getc1995/Scaled-Robot-Cars/code/ubuntu/RC2/um_acc/samples/cpp/tutorial_code/images/imageTextN.png

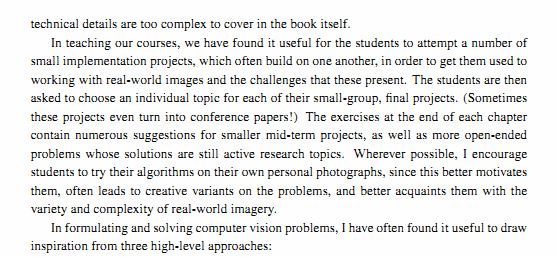
code/ubuntu/RC2/um_acc/samples/cpp/tutorial_code/images/imageTextN.png
