getc1995/Scaled-Robot-Cars/code/ubuntu/RC1/um_acc/samples/cpp/tutorial_code/images/chicky_512.png

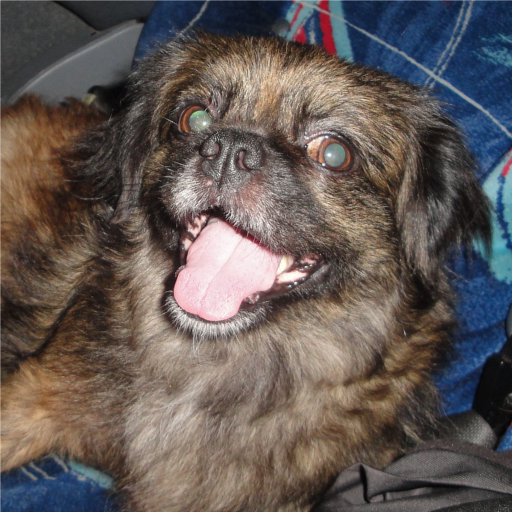
code/ubuntu/RC1/um_acc/samples/cpp/tutorial_code/images/chicky_512.png
