getc1995/Scaled-Robot-Cars/code/ubuntu/RC1/um_acc/cudd-2.5.0/cudd/doc/img22.png

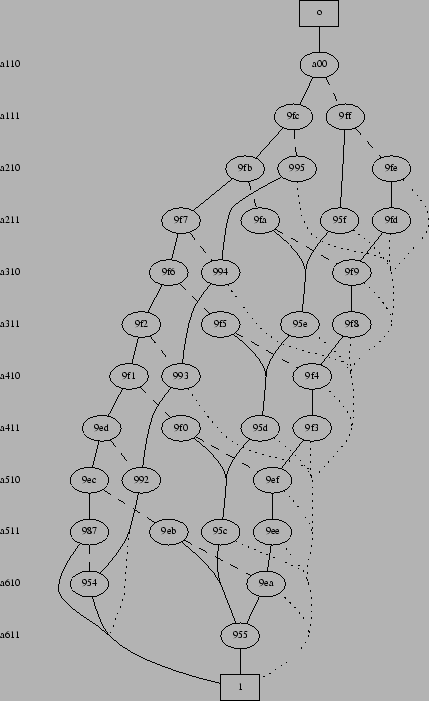
code/ubuntu/RC1/um_acc/cudd-2.5.0/cudd/doc/img22.png
