getc1995/Scaled-Robot-Cars/code/ubuntu/RC1/um_acc/samples/c/baboon200.jpg

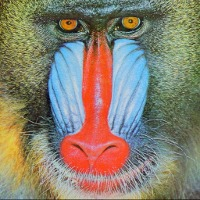
code/ubuntu/RC1/um_acc/samples/c/baboon200.jpg
