getc1995/Scaled-Robot-Cars/code/ubuntu/RC1/um_acc/samples/c/box.png

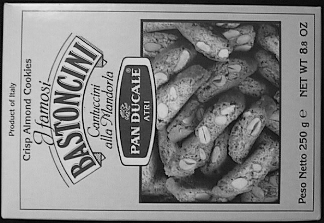
code/ubuntu/RC1/um_acc/samples/c/box.png
