getc1995/Scaled-Robot-Cars/code/ubuntu/RC1/um_acc/samples/c/one_way_train_0000.jpg

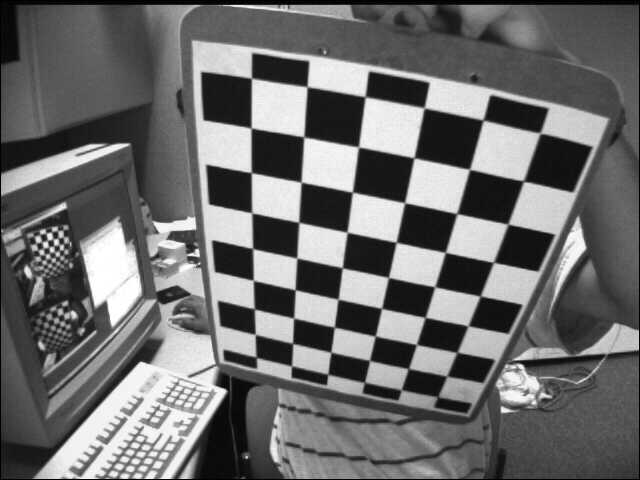
code/ubuntu/RC1/um_acc/samples/c/one_way_train_0000.jpg
