getc1995/Scaled-Robot-Cars/code/ubuntu/RC1/um_acc/samples/c/scene_l.bmp

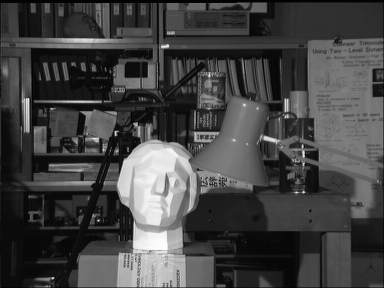
code/ubuntu/RC1/um_acc/samples/c/scene_l.bmp
