getc1995/Scaled-Robot-Cars/code/ubuntu/RC1/um_acc/samples/c/stuff.jpg

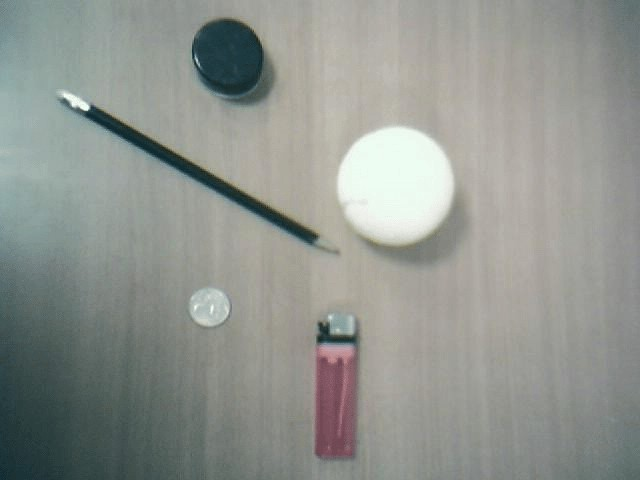
code/ubuntu/RC1/um_acc/samples/c/stuff.jpg
