getc1995/Scaled-Robot-Cars/code/ubuntu/RC1/um_acc/samples/cpp/matching_to_many_images/query.png

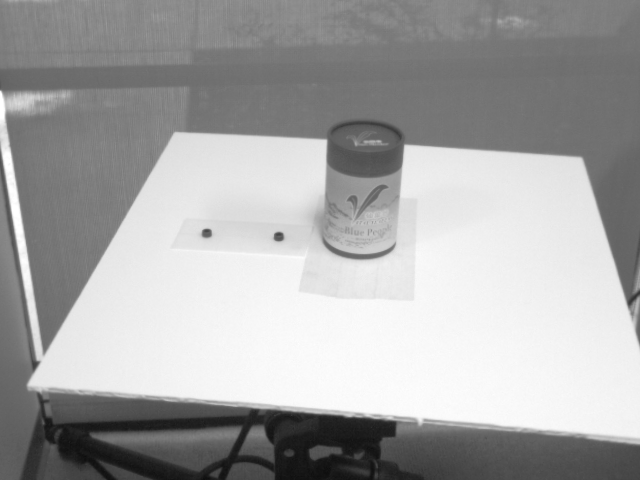
code/ubuntu/RC1/um_acc/samples/cpp/matching_to_many_images/query.png
