getc1995/Scaled-Robot-Cars/code/ubuntu/RC1/um_acc/samples/cpp/matching_to_many_images/train/1.png

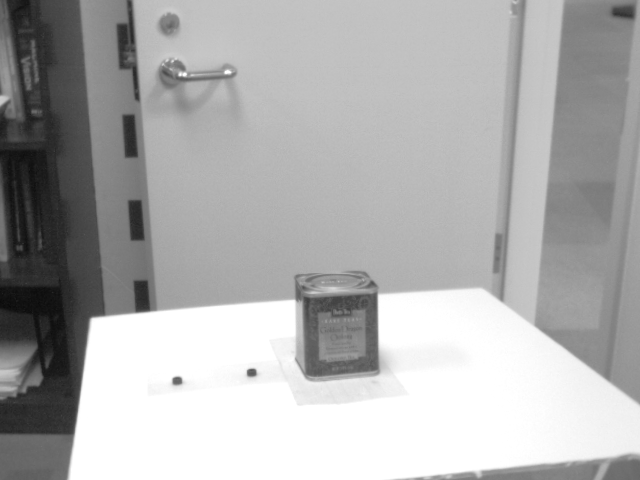
code/ubuntu/RC1/um_acc/samples/cpp/matching_to_many_images/train/1.png
