getc1995/Scaled-Robot-Cars/code/ubuntu/RC1/um_acc/samples/cpp/rgbdodometry/depth_00002.png

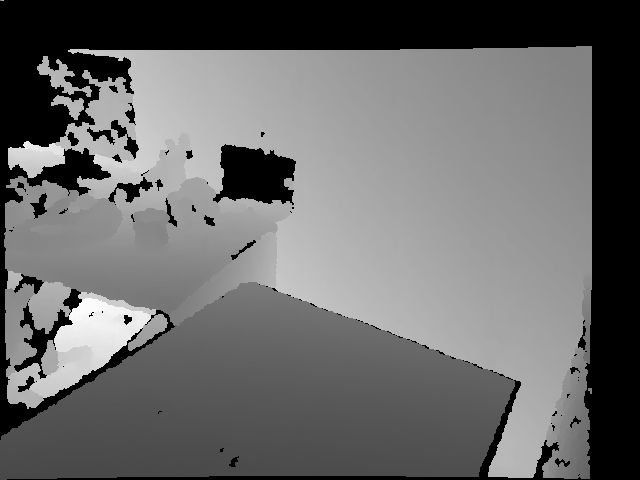
code/ubuntu/RC1/um_acc/samples/cpp/rgbdodometry/depth_00002.png
