getc1995/Scaled-Robot-Cars/code/ubuntu/RC1/um_acc/samples/cpp/rgbdodometry/image_00000.png

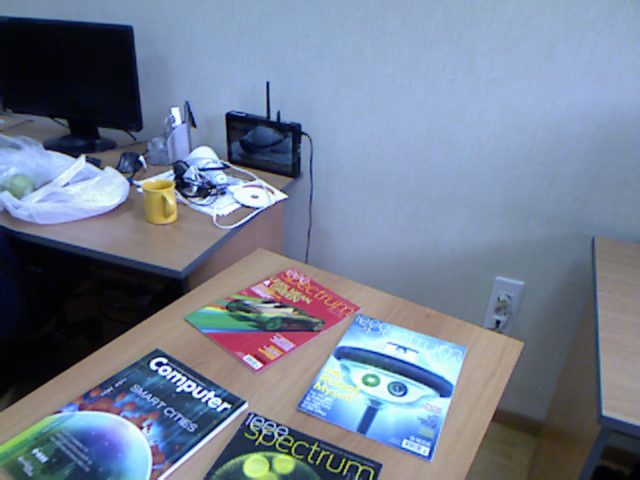
code/ubuntu/RC1/um_acc/samples/cpp/rgbdodometry/image_00000.png
