getc1995/Scaled-Robot-Cars/code/ubuntu/RC1/um_acc/samples/gpu/basketball2.png

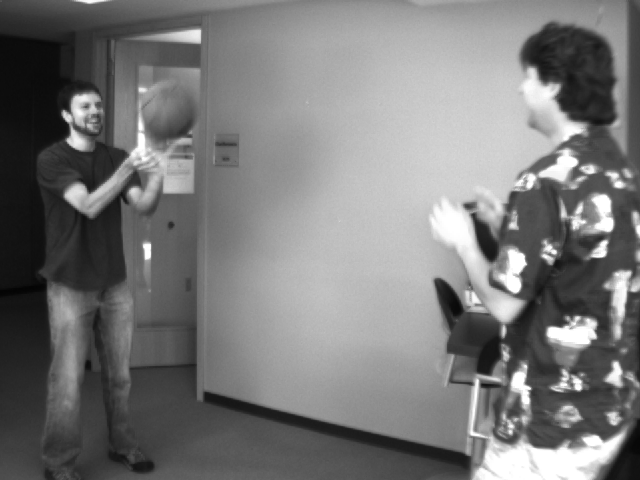
code/ubuntu/RC1/um_acc/samples/gpu/basketball2.png
