getc1995/Scaled-Robot-Cars/code/ubuntu/RC1/um_acc/samples/gpu/tsucuba_right.png

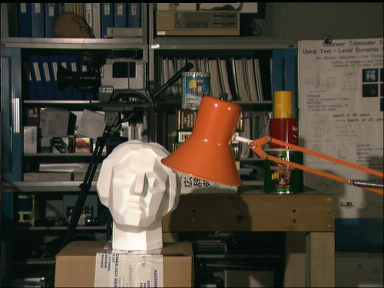
code/ubuntu/RC1/um_acc/samples/gpu/tsucuba_right.png
