getc1995/Scaled-Robot-Cars/code/ubuntu/RC1/um_acc/samples/java/clojure/simple-sample/resources/images/lena.png

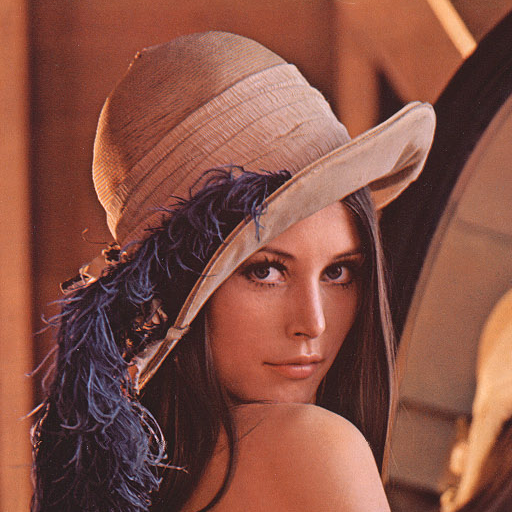
code/ubuntu/RC1/um_acc/samples/java/clojure/simple-sample/resources/images/lena.png
