getc1995/Scaled-Robot-Cars/code/ubuntu/RC1/um_acc/samples/java/sbt/src/main/resources/AverageMaleFace.jpg

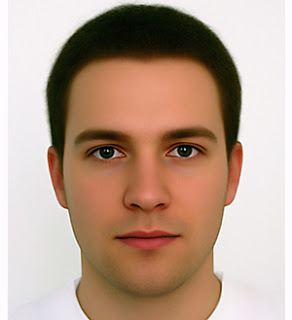
code/ubuntu/RC1/um_acc/samples/java/sbt/src/main/resources/AverageMaleFace.jpg
