getc1995/Scaled-Robot-Cars/code/ubuntu/RC1/um_acc/samples/python2/data/aero3.jpg

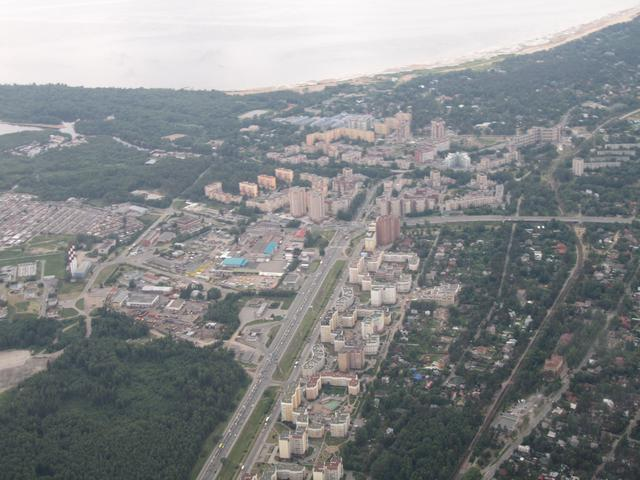
code/ubuntu/RC1/um_acc/samples/python2/data/aero3.jpg
