getc1995/Scaled-Robot-Cars/code/ubuntu/RC1/um_acc/samples/python2/data/starry_night.jpg

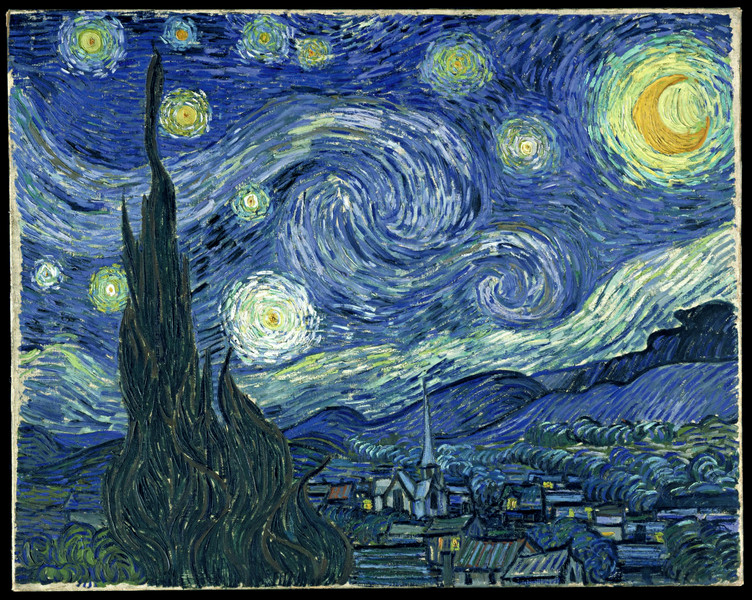
code/ubuntu/RC1/um_acc/samples/python2/data/starry_night.jpg
