getc1995/Scaled-Robot-Cars/code/ubuntu/RC1/um_acc/samples/python2/data/text_defocus.jpg

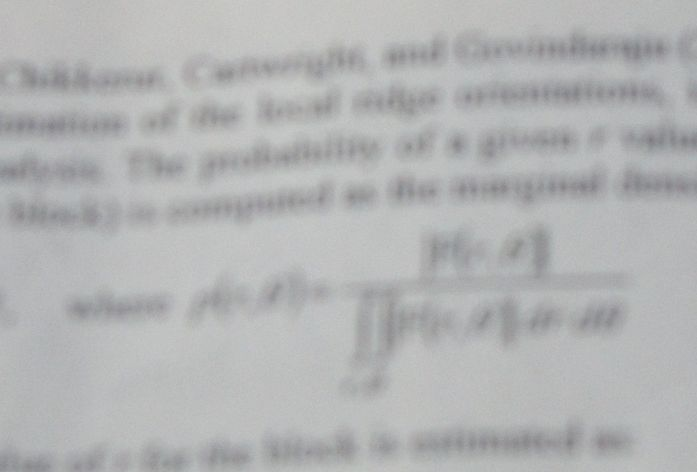
code/ubuntu/RC1/um_acc/samples/python2/data/text_defocus.jpg
