getc1995/Scaled-Robot-Cars/Build instruction/BOM.xlsx

Sheet: Amazon
Items | Price | Quantity | subtotal | Link
Gens ace 5000mAh 11.1V 3S 50C LiPo Battery Pack | 49.99 | 1 | 49.99 | https://www.amazon.com/dp/B01JCSOJIY?colid=3JGNW4QIKLVF0&coliid=I3M5W0S6SITRA4
1/4 th Inch Thick 12 x 12 Inches Acrylic Plexiglass Sheet | 12.99 | 4 | 51.96 | https://www.amazon.com/Source-Premium-Acrylic-PlexiGlass-S1-12x12-25/dp/B00844SOSE
Intocircuit LCD 60W 12V 5A Adapter Charger | 8.89 | 1 | 8.89 | https://www.amazon.com/dp/B0023Y9EQC?colid=3JGNW4QIKLVF0&coliid=I3FMTRIVJX96F
RioRand RC Hobby C23212 LiPo Voltage Checker + Warning Buzzer | 5.69 | 1 | 5.69 | https://www.amazon.com/dp/B003Y6E6IE?colid=3JGNW4QIKLVF0&coliid=I1TYB0BYTV1BZC
GoolRC SKYRC iMAX B6 Mini Professional Balance Charger / Discharger for RC Lipo Battery Charging | 42.99 | 1 | 42.99 | https://www.amazon.com/dp/B00L5YBJI2?colid=3JGNW4QIKLVF0&coliid=ISOXJGNL6SY91
Traxxas 2946 Charge Lead | 7.26 | 3 | 21.78 | https://www.amazon.com/dp/B00BMQGEZQ?colid=3JGNW4QIKLVF0&coliid=I37X9Q7A45ZTN4
WEN 74603 26-Inch 3 Drawer Intermediate Chest, Silver/Black | 63.74 | 1 | 63.74 | https://www.amazon.com/WEN-74603-26-Inch-Drawer-Intermediate/dp/B00B1NPU3W/ref=cm_wl_huc_item
Cal-Hawk 120 Fuses 5, 7.5, 10,15,20,25,30 AMP Automotive Fuses, Car Truck Fuses | 7.5 | 1 | 7.5 | https://www.amazon.com/Cal-Hawk-120-Fuses-Automotive-Truck/dp/B0042XORMI
 |  | total | 252.54

Sheet: Mcmaster
Items | Price | Quantity | subtotal | Link
Steel Phillips Rounded Head Screw M2 x 0.4 mm Thread, 10 mm Long | 3.67 | 1 | 3.67 | https://www.mcmaster.com/#92005A033
Aluminum Female Threaded Hex Standoff 6 mm Hex Size, 13 mm Length, M3 Thread Size | 0.52 | 20 | 10.4 | https://www.mcmaster.com/#95947A042
Aluminum Male-Female Threaded Hex Standoff 6 mm Hex Size, 31 mm Length, M3 Thread Size | 2.11 | 10 | 21.1 | https://www.mcmaster.com/#98952A073
Aluminum Female Threaded Hex Standoff 6 mm Hex Size, 30 mm Length, M3 Thread Size | 1.22 | 10 | 12.2 | https://www.mcmaster.com/#95947A060
Steel Hex Nut Low-Strength, M2 x 0.4 mm Thread | 1.04 | 1 | 1.04 | https://www.mcmaster.com/#90592A004
Medium-Strength Steel Nylon-Insert Locknut Class 8, Zinc-Plated, M3 x 0.5 mm Thread | 3.27 | 1 | 3.27 | https://www.mcmaster.com/#90576A102
Nylon Plastic Washer for M2 Screw Size, 2.2 mm ID, 5 mm OD | 2.63 | 1 | 2.63 | https://www.mcmaster.com/#95610a510/=16fyr81
Hex Drive Rounded Head Screw Black-Oxide Alloy Steel, M3 x 0.5 mm Thread, 10 mm Long | 6.88 | 1 | 6.88 | https://www.mcmaster.com/#91239A115
Hex Drive Rounded Head Screw Black-Oxide Alloy Steel, M3 x 0.5 mm Thread, 16 mm Long | 9.47 | 1 | 9.47 | https://www.mcmaster.com/#91239A120
Hex Drive Rounded Head Screw Black-Oxide Alloy Steel, M3 x 0.5 mm Thread, 6 mm Long | 6.88 | 1 | 6.88 | https://www.mcmaster.com/#91239A111
Nylon Plastic Washer for M3 Screw Size, 3.2 mm ID, 8 mm OD | 2.92 | 1 | 2.92 | https://www.mcmaster.com/#95610a530/=16fyry7
Steel Small-Parts Cabinet with 20 Plastic Drawers, 12" High x 16-1/2" Wide x 6-1/2" Deep | 90.25 | 1 | 90.25 | https://www.mcmaster.com/#4532T51
 |  | total | 170.71

Sheet: Robotshop
Items | Price | Quantity | subtotal | Link
LIDAR-Lite v3 | 119.67 | 1 | 119.67 | http://www.robotshop.com/en/lidar-lite-3-laser-rangefinder.html
LIDAR-Lite V3 Cable | 4.99 | 2 | 9.98 | http://www.robotshop.com/en/lidar-lite-v3-cable.html
SH-1 Soldering Iron Holder | 3.49 | 1 | 3.49 | http://www.robotshop.com/en/elenco-soldering-iron-holder.html
9 Degrees of Freedom - Razor M0 IMU | 49.95 | 1 | 49.95 | http://www.robotshop.com/en/9-degrees-of-freedom-razor-m0-imu.html
Classic Solderless Breadboard | 9.95 | 1 | 9.95 | http://www.robotshop.com/en/classic-solderless-breadboard.html
Terminal to 2.1mm Barrel Jack | 0.58 | 4 | 2.32 | http://www.robotshop.com/en/terminal-barrel-jack.html
Rocker Switch | 0.95 | 4 | 3.8 | http://www.robotshop.com/en/sfe-on-off-rocker-switch.html
Break Away Headers - Straight (10 pack) | 1.8 | 1 | 1.8 | http://www.robotshop.com/en/break-away-headers-straight.html
15A Waterproof Fuse Holder (Medium) | 4.18 | 1 | 4.18 | http://www.robotshop.com/en/15a-waterproof-fuse-holder-medium.html
 |  | total | 205.14

Sheet: Pololu
Items | Price | Quantity | subtotal | Link
Pololu 12V, 15A Step-Down Voltage Regulator D24V150F12 | 39.95 | 1 | 39.95 | https://www.pololu.com/product/2885
 |  | total | 39.95
