getc1995/Scaled-Robot-Cars/Build instruction/budget.xlsx

Sheet: A copy of the scaled car
 | unit price | Quantity
Motor | 300 | 1 | 300
Hokuyo UST-10LX Scanning Laser Rangefinder | 1700 | 1 | 1700
Traxxas 1/10 Slash 4X4 | 400 | 1 | 400
TK1 | 200 | 1 | 200
Arduino Mega | 40 | 1 | 40
3-Port USB 3.0 Portable Data Hub with 1 Gbps Ethernet | 24 | 1 | 24
USB 3.0 Hub | 8 | 1 | 8
IMU | 50 | 1 | 50
wiring and cables | 20 | 1 | 20
wifi | 80 | 1 | 80
3D printing and mechanical supports | 80 | 1 | 80
battery packs for motor | 60 | 1 | 60
battery packs for TK1 | 60 | 2 | 120
webcam | 30 | 1 | 30
 |  |  | 3112

Sheet: Encoder on the board
 | Unit Price | Quantity
Arduino Mega | 40 | 2 | 80
Bluetooth module | 10.59 | 2 | 21.18
Encoder | 17.99 | 1 | 17.99 | https://www.amazon.com/dp/B00UTIFCVA/_encoding=UTF8?coliid=I30JWL4OJGWUQ7&colid=3JGNW4QIKLVF0
Wheel | 10 | 1 | 10
Mechnical supports | 7.31 | 1 | 7.31
 |  |  | 136.48
