getc1995/Scaled-Robot-Cars/hardware/CAD/Assemble.SLDASM

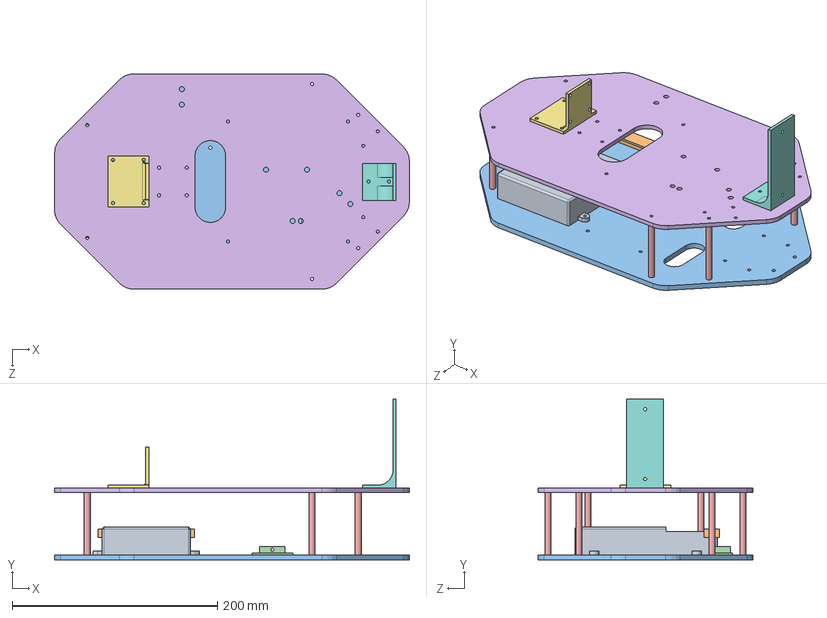
[picture p43: CAD file, 2018-04-26]
hardware/CAD/Assemble.SLDASM
346.3 x 157.0 x 210.0 mm
powerPack
door
lowerBase
switch
standing x 6
upperBase
LIDAR
wifi
