getc1995/Scaled-Robot-Cars/code/ubuntu/RC1/um_acc/samples/cpp/tutorial_code/viz/bunny.ply

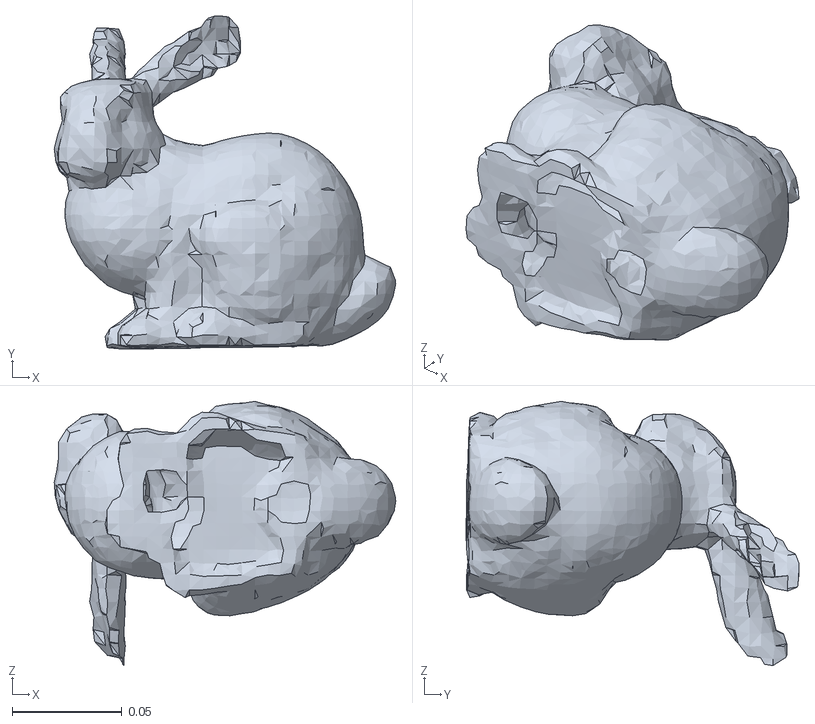
[picture p44: CAD file, 2018-04-26]
code/ubuntu/RC1/um_acc/samples/cpp/tutorial_code/viz/bunny.ply
0.155 x 0.151 x 0.12
