getc1995/Scaled-Robot-Cars/hardware/CAD/door.SLDPRT

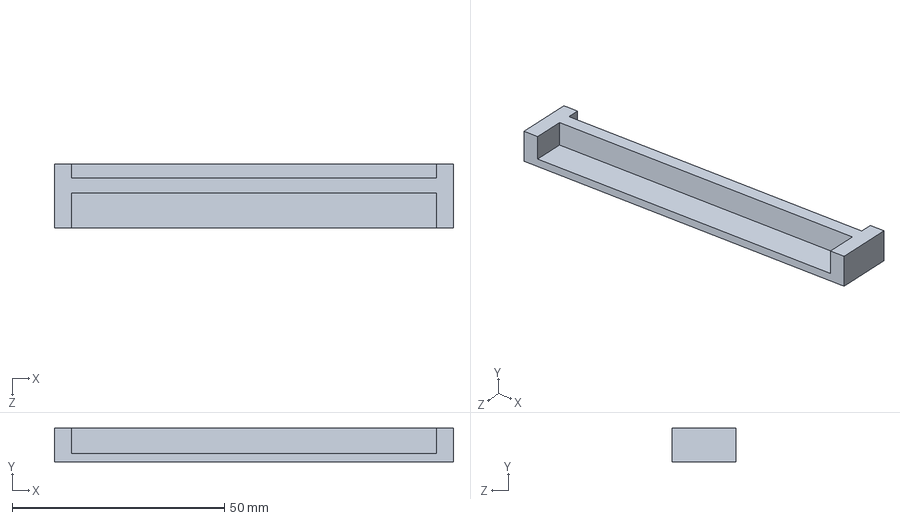
[picture p45: CAD file, 2018-04-26]
hardware/CAD/door.SLDPRT
94.0 x 8.00 x 15.0 mm
