getc1995/Scaled-Robot-Cars/hardware/CAD/wifi.SLDPRT

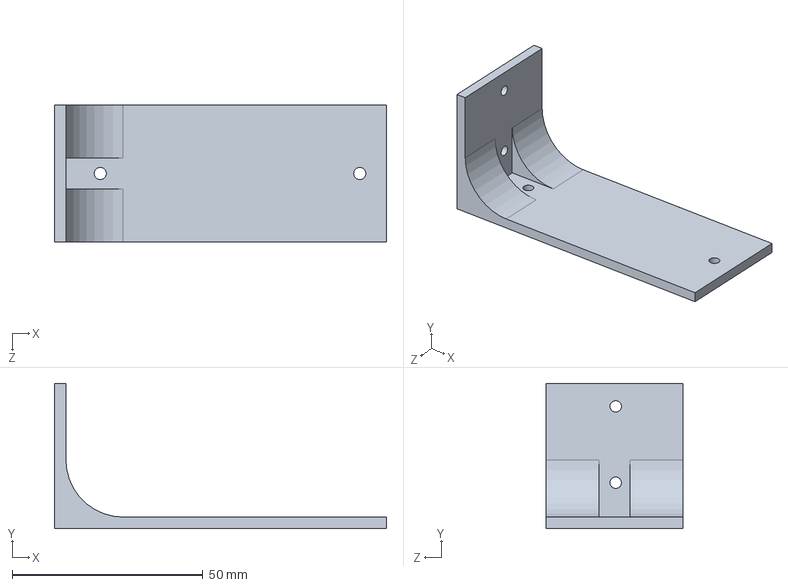
[picture p46: CAD file, 2018-04-26]
hardware/CAD/wifi.SLDPRT
87.0 x 38.0 x 36.0 mm
