getc1995/Scaled-Robot-Cars/hardware/CAD/upperBase2.SLDPRT

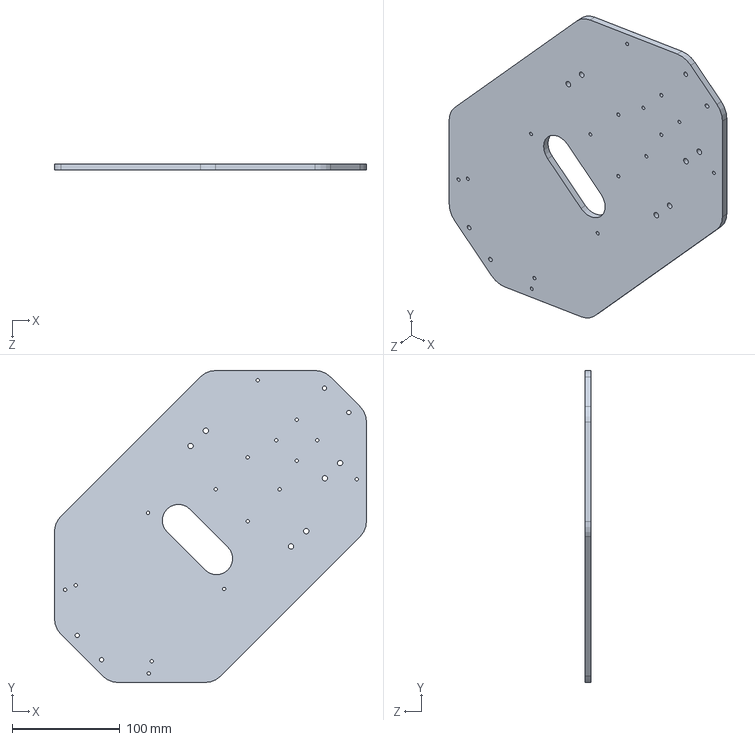
[picture p47: CAD file, 2018-04-26]
hardware/CAD/upperBase2.SLDPRT
290.0 x 290.0 x 6.00 mm
