getc1995/Scaled-Robot-Cars/hardware/CAD/switch.SLDPRT

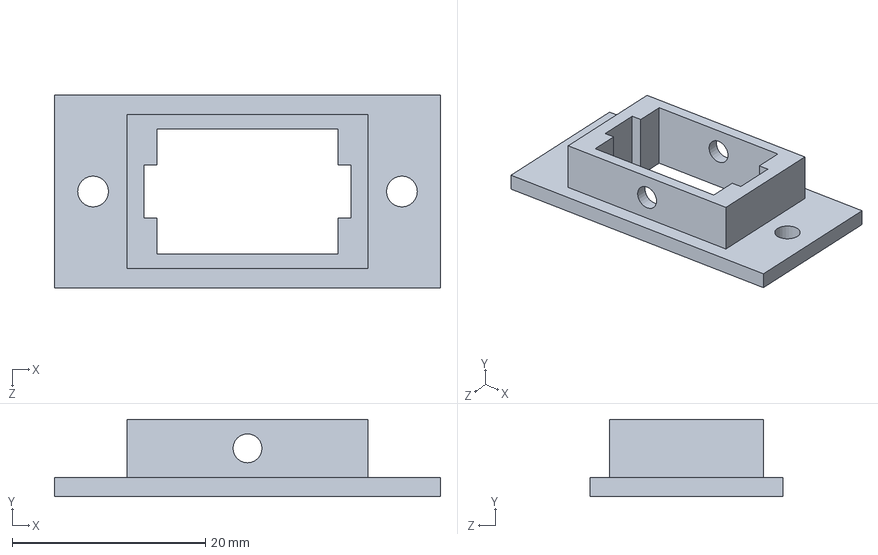
[picture p48: CAD file, 2018-04-26]
hardware/CAD/switch.SLDPRT
40.0 x 8.00 x 20.0 mm
