getc1995/Scaled-Robot-Cars/hardware/CAD/camera_mount.SLDPRT

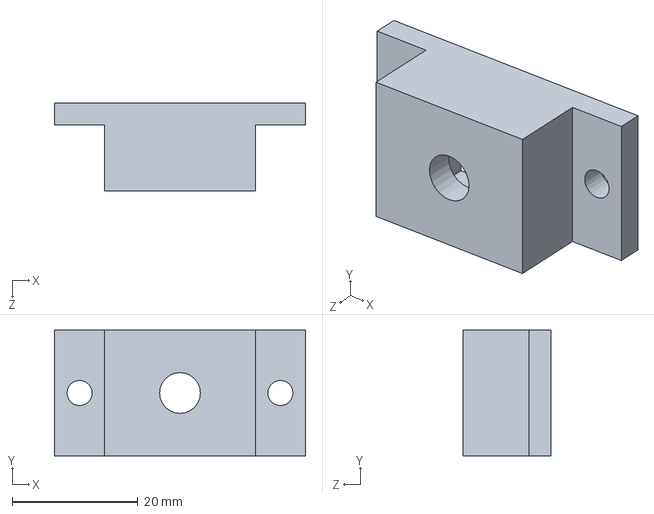
[picture p49: CAD file, 2018-04-26]
hardware/CAD/camera_mount.SLDPRT
40.0 x 20.0 x 14.0 mm
