getc1995/Scaled-Robot-Cars/hardware/CAD/standing.SLDPRT

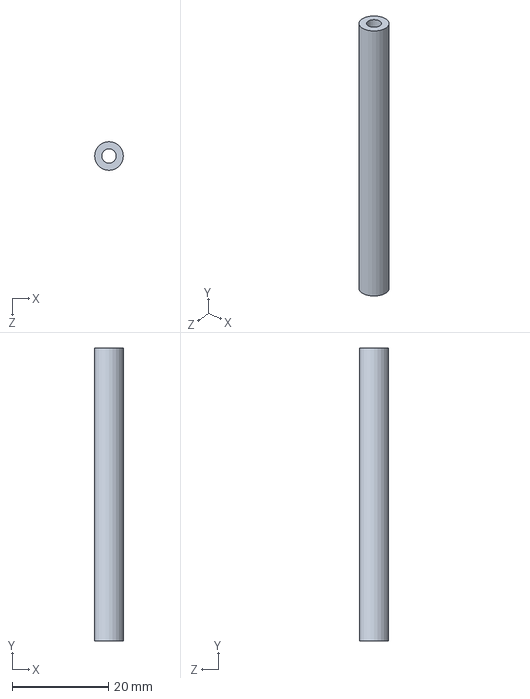
[picture p50: CAD file, 2018-04-26]
hardware/CAD/standing.SLDPRT
6.00 x 61.0 x 6.00 mm
