getc1995/Scaled-Robot-Cars/hardware/CAD/lowerBase.SLDPRT

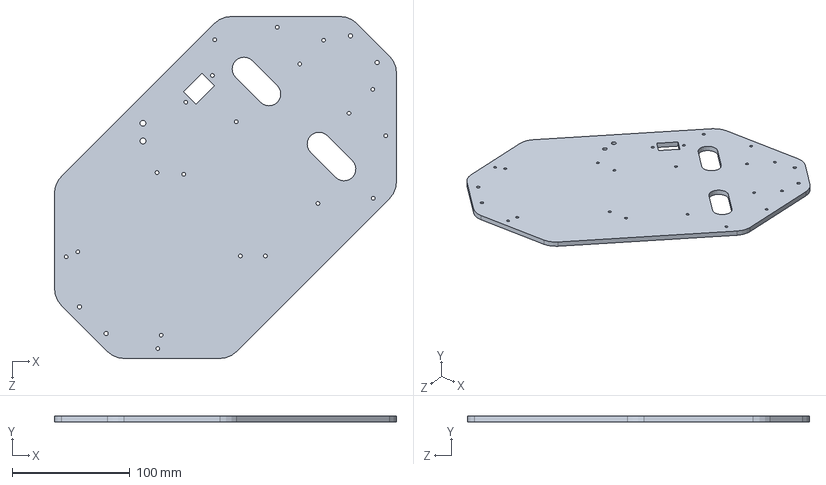
[picture p51: CAD file, 2018-04-26]
hardware/CAD/lowerBase.SLDPRT
290.0 x 5.00 x 290.0 mm
