getc1995/Scaled-Robot-Cars/hardware/CAD/powerPack.SLDPRT

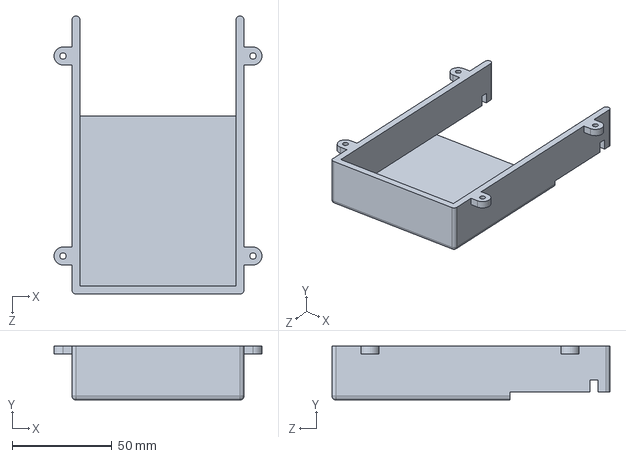
[picture p52: CAD file, 2018-04-26]
hardware/CAD/powerPack.SLDPRT
104.0 x 27.0 x 139.0 mm
