getc1995/Scaled-Robot-Cars/hardware/CAD/LIDAR.SLDPRT

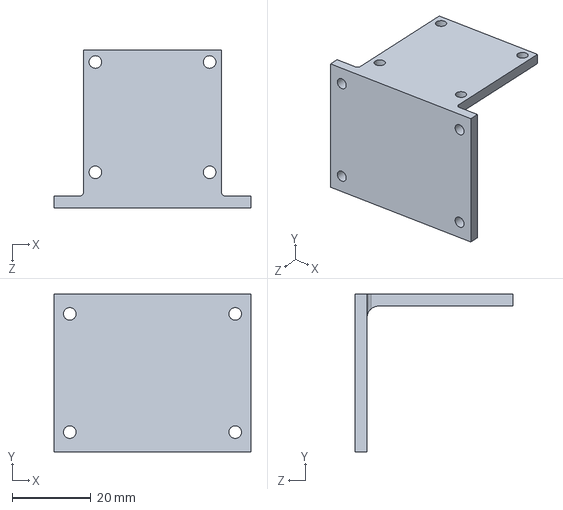
[picture p53: CAD file, 2018-04-26]
hardware/CAD/LIDAR.SLDPRT
50.0 x 40.0 x 40.0 mm
