getc1995/Scaled-Robot-Cars/hardware/CAD/Elmo.SLDPRT

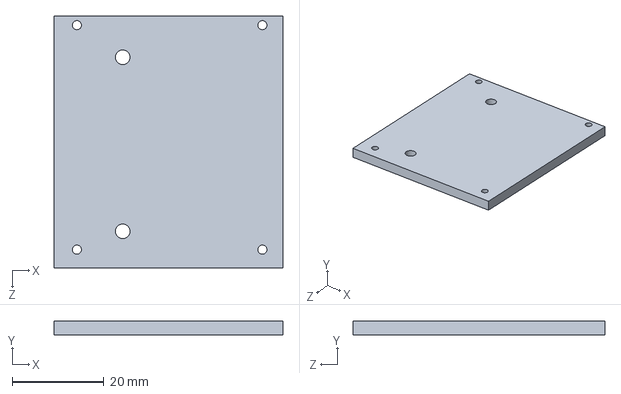
[picture p54: CAD file, 2018-04-26]
hardware/CAD/Elmo.SLDPRT
50.0 x 3.00 x 55.0 mm
