getc1995/Scaled-Robot-Cars/hardware/CAD/upperBase.SLDPRT

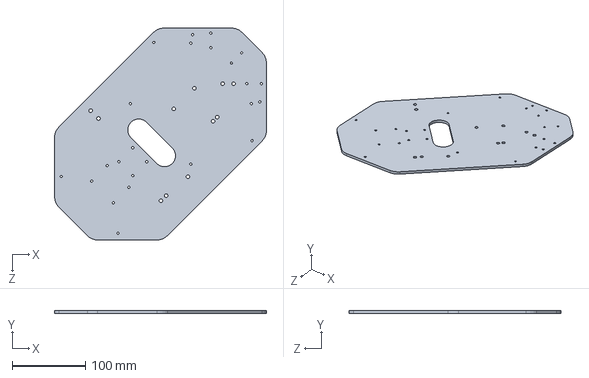
[picture p55: CAD file, 2018-04-26]
hardware/CAD/upperBase.SLDPRT
290.0 x 4.00 x 290.0 mm
