getc1995/Scaled-Robot-Cars/(list of files, cad)

Other CAD files:
hardware/CAD/lowerBase2.SLDPRT
hardware/CAD/Elmo.STL
hardware/CAD/LIDAR.STL
hardware/CAD/camera_mount.STL
hardware/CAD/door.STL
hardware/CAD/powerPack.STL
hardware/CAD/switch.STL
hardware/CAD/wifi.STL
