getc1995/Scaled-Robot-Cars/Build instruction/Documentation.docx

Documentation

Edit the script to execute on the start of terminal:

gedit ~/.bashrc

ros rviz segmentation fault:

echo "unset GTK_IM_MODULE" >> ~/.bashrc

source ~/.bashrc

(Restart terminal)
