getc1995/Scaled-Robot-Cars/code/ubuntu/RC1/um_acc/samples/cpp/tutorial_code/images/hand_sample3.jpg

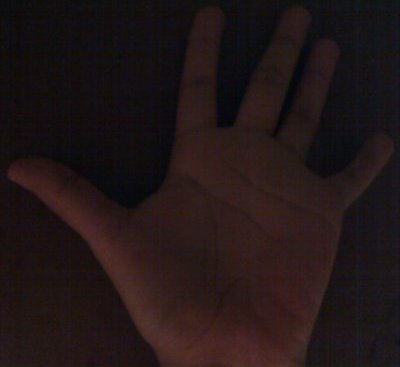
code/ubuntu/RC1/um_acc/samples/cpp/tutorial_code/images/hand_sample3.jpg
