getc1995/Scaled-Robot-Cars/code/ubuntu/RC1/um_acc/samples/cpp/tutorial_code/images/imageTextR.png

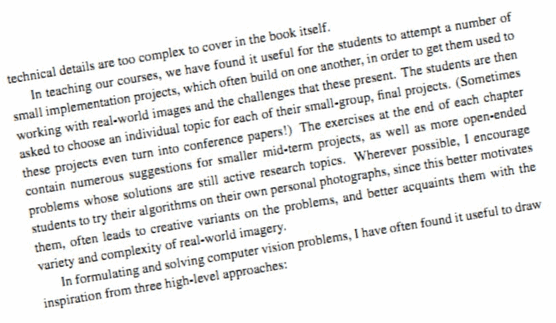
code/ubuntu/RC1/um_acc/samples/cpp/tutorial_code/images/imageTextR.png
