getc1995/Scaled-Robot-Cars/code/ubuntu/RC1/um_acc/camera_calibration/picture2.jpg

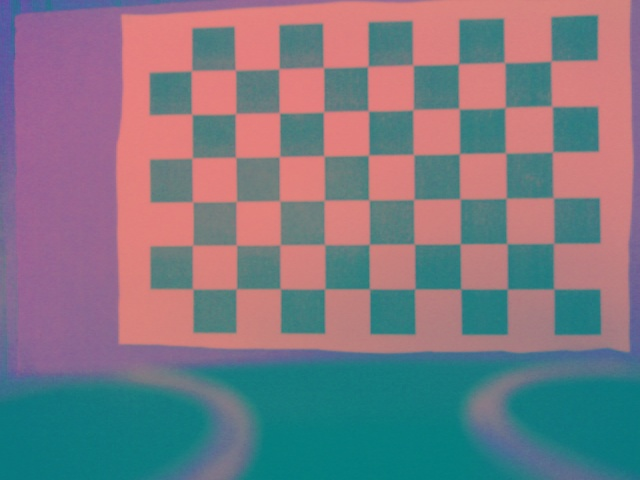
code/ubuntu/RC1/um_acc/camera_calibration/picture2.jpg
