getc1995/Scaled-Robot-Cars/code/ubuntu/RC1/um_acc/samples/cpp/fabmap/stlucia_test_small0002.jpeg

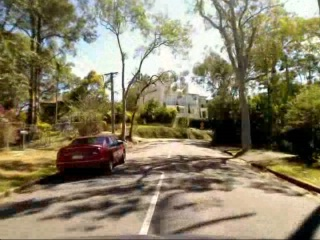
code/ubuntu/RC1/um_acc/samples/cpp/fabmap/stlucia_test_small0002.jpeg
