getc1995/Scaled-Robot-Cars/code/ubuntu/RC1/um_acc/samples/cpp/fabmap/stlucia_test_small0004.jpeg

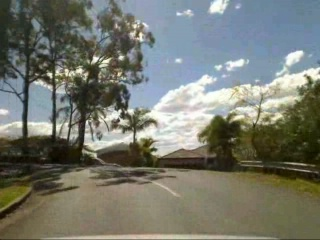
code/ubuntu/RC1/um_acc/samples/cpp/fabmap/stlucia_test_small0004.jpeg
