getc1995/Scaled-Robot-Cars/code/ubuntu/RC1/um_acc/src/Car_parameters.h

#define CPS2V 0.004653//countPerSecond to velocity
#define MAXCURRENT 0.25
#define SERVOMID 1419
#define SERVOMAXAMP 200 //Maximal servo amplitude
#define CARID 1
