getc1995/Scaled-Robot-Cars/code/ubuntu/RC1/um_acc/src/accsolver.cpp

/* Produced by CVXGEN, 2018-02-12 21:04:51 -0500.  */
/* CVXGEN is Copyright (C) 2006-2017 Jacob Mattingley, jem@cvxgen.com. */
/* The code in this file is Copyright (C) 2006-2017 Jacob Mattingley. */
/* CVXGEN, or solvers produced by CVXGEN, cannot be used for commercial */
/* applications without prior written permission from Jacob Mattingley. */

/* Filename: solver.c. */
/* Description: Main solver file. */
#include "accsolver.h"
double eval_gap(void) {
  int i;
  double gap;
  gap = 0;
  for (i = 0; i < 100; i++)
    gap += work.z[i]*work.s[i];
  return gap;
}
void set_defaults(void) {
  settings.resid_tol = 1e-6;
  settings.eps = 1e-4;
  settings.max_iters = 25;
  settings.refine_steps = 1;
  settings.s_init = 1;
  settings.z_init = 1;
  settings.debug = 0;
  settings.verbose = 1;
  settings.verbose_refinement = 0;
  settings.better_start = 1;
  settings.kkt_reg = 1e-7;
}
void setup_pointers(void) {
  work.y = work.x + 159;
  work.s = work.x + 298;
  work.z = work.x + 398;
  vars.u_1 = work.x + 59;
  vars.u_2 = work.x + 60;
  vars.u_3 = work.x + 61;
  vars.u_4 = work.x + 62;
  vars.u_5 = work.x + 63;
  vars.u_6 = work.x + 64;
  vars.u_7 = work.x + 65;
  vars.u_8 = work.x + 66;
  vars.u_9 = work.x + 67;
  vars.u_10 = work.x + 68;
  vars.u_11 = work.x + 69;
  vars.u_12 = work.x + 70;
  vars.u_13 = work.x + 71;
  vars.u_14 = work.x + 72;
  vars.u_15 = work.x + 73;
  vars.u_16 = work.x + 74;
  vars.u_17 = work.x + 75;
  vars.u_18 = work.x + 76;
  vars.u_19 = work.x + 77;
  vars.u_20 = work.x + 78;
  vars.x_1 = work.x + 79;
  vars.x_2 = work.x + 81;
  vars.x_3 = work.x + 83;
  vars.x_4 = work.x + 85;
  vars.x_5 = work.x + 87;
  vars.x_6 = work.x + 89;
  vars.x_7 = work.x + 91;
  vars.x_8 = work.x + 93;
  vars.x_9 = work.x + 95;
  vars.x_10 = work.x + 97;
  vars.x_11 = work.x + 99;
  vars.x_12 = work.x + 101;
  vars.x_13 = work.x + 103;
  vars.x_14 = work.x + 105;
  vars.x_15 = work.x + 107;
  vars.x_16 = work.x + 109;
  vars.x_17 = work.x + 111;
  vars.x_18 = work.x + 113;
  vars.x_19 = work.x + 115;
  vars.x_20 = work.x + 117;
  vars.xr_1 = work.x + 119;
  vars.xr_2 = work.x + 121;
  vars.xr_3 = work.x + 123;
  vars.xr_4 = work.x + 125;
  vars.xr_5 = work.x + 127;
  vars.xr_6 = work.x + 129;
  vars.xr_7 = work.x + 131;
  vars.xr_8 = work.x + 133;
  vars.xr_9 = work.x + 135;
  vars.xr_10 = work.x + 137;
  vars.xr_11 = work.x + 139;
  vars.xr_12 = work.x + 141;
  vars.xr_13 = work.x + 143;
  vars.xr_14 = work.x + 145;
  vars.xr_15 = work.x + 147;
  vars.xr_16 = work.x + 149;
  vars.xr_17 = work.x + 151;
  vars.xr_18 = work.x + 153;
  vars.xr_19 = work.x + 155;
  vars.xr_20 = work.x + 157;
}
void setup_indexed_params(void) {
  /* In CVXGEN, you can say */
  /*   parameters */
  /*     A[i] (5,3), i=1..4 */
  /*   end */
  /* This function sets up A[2] to be a pointer to A_2, which is a length-15 */
  /* vector of doubles. */
  /* If you access parameters that you haven't defined in CVXGEN, the result */
  /* is undefined. */
  params.u[0] = params.u_0;
  params.x[0] = params.x_0;
}
void setup_indexed_optvars(void) {
  /* In CVXGEN, you can say */
  /*   variables */
  /*     x[i] (5), i=2..4 */
  /*   end */
  /* This function sets up x[3] to be a pointer to x_3, which is a length-5 */
  /* vector of doubles. */
  /* If you access variables that you haven't defined in CVXGEN, the result */
  /* is undefined. */
  vars.x[1] = vars.x_1;
  vars.xr[1] = vars.xr_1;
  vars.x[2] = vars.x_2;
  vars.xr[2] = vars.xr_2;
  vars.x[3] = vars.x_3;
  vars.xr[3] = vars.xr_3;
  vars.x[4] = vars.x_4;
  vars.xr[4] = vars.xr_4;
  vars.x[5] = vars.x_5;
  vars.xr[5] = vars.xr_5;
  vars.x[6] = vars.x_6;
  vars.xr[6] = vars.xr_6;
  vars.x[7] = vars.x_7;
  vars.xr[7] = vars.xr_7;
  vars.x[8] = vars.x_8;
  vars.xr[8] = vars.xr_8;
  vars.x[9] = vars.x_9;
  vars.xr[9] = vars.xr_9;
  vars.x[10] = vars.x_10;
  vars.xr[10] = vars.xr_10;
  vars.x[11] = vars.x_11;
  vars.xr[11] = vars.xr_11;
  vars.x[12] = vars.x_12;
  vars.xr[12] = vars.xr_12;
  vars.x[13] = vars.x_13;
  vars.xr[13] = vars.xr_13;
  vars.x[14] = vars.x_14;
  vars.xr[14] = vars.xr_14;
  vars.x[15] = vars.x_15;
  vars.xr[15] = vars.xr_15;
  vars.x[16] = vars.x_16;
  vars.xr[16] = vars.xr_16;
  vars.x[17] = vars.x_17;
  vars.xr[17] = vars.xr_17;
  vars.x[18] = vars.x_18;
  vars.xr[18] = vars.xr_18;
  vars.x[19] = vars.x_19;
  vars.xr[19] = vars.xr_19;
  vars.x[20] = vars.x_20;
  vars.xr[20] = vars.xr_20;
  vars.u[1] = vars.u_1;
  vars.u[2] = vars.u_2;
  vars.u[3] = vars.u_3;
  vars.u[4] = vars.u_4;
  vars.u[5] = vars.u_5;
  vars.u[6] = vars.u_6;
  vars.u[7] = vars.u_7;
  vars.u[8] = vars.u_8;
  vars.u[9] = vars.u_9;
  vars.u[10] = vars.u_10;
  vars.u[11] = vars.u_11;
  vars.u[12] = vars.u_12;
  vars.u[13] = vars.u_13;
  vars.u[14] = vars.u_14;
  vars.u[15] = vars.u_15;
  vars.u[16] = vars.u_16;
  vars.u[17] = vars.u_17;
  vars.u[18] = vars.u_18;
  vars.u[19] = vars.u_19;
  vars.u[20] = vars.u_20;
}
void setup_indexing(void) {
  setup_pointers();
  setup_indexed_params();
  setup_indexed_optvars();
}
void set_start(void) {
  int i;
  for (i = 0; i < 159; i++)
    work.x[i] = 0;
  for (i = 0; i < 139; i++)
    work.y[i] = 0;
  for (i = 0; i < 100; i++)
    work.s[i] = (work.h[i] > 0) ? work.h[i] : settings.s_init;
  for (i = 0; i < 100; i++)
    work.z[i] = settings.z_init;
}
double eval_objv(void) {
  int i;
  double objv;
  /* Borrow space in work.rhs. */
  multbyP(work.rhs, work.x);
  objv = 0;
  for (i = 0; i < 159; i++)
    objv += work.x[i]*work.rhs[i];
  objv *= 0.5;
  for (i = 0; i < 159; i++)
    objv += work.q[i]*work.x[i];
  objv += work.quad_397717204992[0];
  return objv;
}
void fillrhs_aff(void) {
  int i;
  double *r1, *r2, *r3, *r4;
  r1 = work.rhs;
  r2 = work.rhs + 159;
  r3 = work.rhs + 259;
  r4 = work.rhs + 359;
  /* r1 = -A^Ty - G^Tz - Px - q. */
  multbymAT(r1, work.y);
  multbymGT(work.buffer, work.z);
  for (i = 0; i < 159; i++)
    r1[i] += work.buffer[i];
  multbyP(work.buffer, work.x);
  for (i = 0; i < 159; i++)
    r1[i] -= work.buffer[i] + work.q[i];
  /* r2 = -z. */
  for (i = 0; i < 100; i++)
    r2[i] = -work.z[i];
  /* r3 = -Gx - s + h. */
  multbymG(r3, work.x);
  for (i = 0; i < 100; i++)
    r3[i] += -work.s[i] + work.h[i];
  /* r4 = -Ax + b. */
  multbymA(r4, work.x);
  for (i = 0; i < 139; i++)
    r4[i] += work.b[i];
}
void fillrhs_cc(void) {
  int i;
  double *r2;
  double *ds_aff, *dz_aff;
  double mu;
  double alpha;
  double sigma;
  double smu;
  double minval;
  r2 = work.rhs + 159;
  ds_aff = work.lhs_aff + 159;
  dz_aff = work.lhs_aff + 259;
  mu = 0;
  for (i = 0; i < 100; i++)
    mu += work.s[i]*work.z[i];
  /* Don't finish calculating mu quite yet. */
  /* Find min(min(ds./s), min(dz./z)). */
  minval = 0;
  for (i = 0; i < 100; i++)
    if (ds_aff[i] < minval*work.s[i])
      minval = ds_aff[i]/work.s[i];
  for (i = 0; i < 100; i++)
    if (dz_aff[i] < minval*work.z[i])
      minval = dz_aff[i]/work.z[i];
  /* Find alpha. */
  if (-1 < minval)
      alpha = 1;
  else
      alpha = -1/minval;
  sigma = 0;
  for (i = 0; i < 100; i++)
    sigma += (work.s[i] + alpha*ds_aff[i])*
      (work.z[i] + alpha*dz_aff[i]);
  sigma /= mu;
  sigma = sigma*sigma*sigma;
  /* Finish calculating mu now. */
  mu *= 0.01;
  smu = sigma*mu;
  /* Fill-in the rhs. */
  for (i = 0; i < 159; i++)
    work.rhs[i] = 0;
  for (i = 259; i < 498; i++)
    work.rhs[i] = 0;
  for (i = 0; i < 100; i++)
    r2[i] = work.s_inv[i]*(smu - ds_aff[i]*dz_aff[i]);
}
void refine(double *target, double *var) {
  int i, j;
  double *residual = work.buffer;
  double norm2;
  double *new_var = work.buffer2;
  for (j = 0; j < settings.refine_steps; j++) {
    norm2 = 0;
    matrix_multiply(residual, var);
    for (i = 0; i < 498; i++) {
      residual[i] = residual[i] - target[i];
      norm2 += residual[i]*residual[i];
    }
#ifndef ZERO_LIBRARY_MODE
    if (settings.verbose_refinement) {
      if (j == 0)
        printf("Initial residual before refinement has norm squared %.6g.\n", norm2);
      else
        printf("After refinement we get squared norm %.6g.\n", norm2);
    }
#endif
    /* Solve to find new_var = KKT \ (target - A*var). */
    ldl_solve(residual, new_var);
    /* Update var += new_var, or var += KKT \ (target - A*var). */
    for (i = 0; i < 498; i++) {
      var[i] -= new_var[i];
    }
  }
#ifndef ZERO_LIBRARY_MODE
  if (settings.verbose_refinement) {
    /* Check the residual once more, but only if we're reporting it, since */
    /* it's expensive. */
    norm2 = 0;
    matrix_multiply(residual, var);
    for (i = 0; i < 498; i++) {
      residual[i] = residual[i] - target[i];
      norm2 += residual[i]*residual[i];
    }
    if (j == 0)
      printf("Initial residual before refinement has norm squared %.6g.\n", norm2);
    else
      printf("After refinement we get squared norm %.6g.\n", norm2);
  }
#endif
}
double calc_ineq_resid_squared(void) {
  /* Calculates the norm ||-Gx - s + h||. */
  double norm2_squared;
  int i;
  /* Find -Gx. */
  multbymG(work.buffer, work.x);
  /* Add -s + h. */
  for (i = 0; i < 100; i++)
    work.buffer[i] += -work.s[i] + work.h[i];
  /* Now find the squared norm. */
  norm2_squared = 0;
  for (i = 0; i < 100; i++)
    norm2_squared += work.buffer[i]*work.buffer[i];
  return norm2_squared;
}
double calc_eq_resid_squared(void) {
  /* Calculates the norm ||-Ax + b||. */
  double norm2_squared;
  int i;
  /* Find -Ax. */
  multbymA(work.buffer, work.x);
  /* Add +b. */
  for (i = 0; i < 139; i++)
    work.buffer[i] += work.b[i];
  /* Now find the squared norm. */
  norm2_squared = 0;
  for (i = 0; i < 139; i++)
    norm2_squared += work.buffer[i]*work.buffer[i];
  return norm2_squared;
}
void better_start(void) {
  /* Calculates a better starting point, using a similar approach to CVXOPT. */
  /* Not yet speed optimized. */
  int i;
  double *x, *s, *z, *y;
  double alpha;
  work.block_33[0] = -1;
  /* Make sure sinvz is 1 to make hijacked KKT system ok. */
  for (i = 0; i < 100; i++)
    work.s_inv_z[i] = 1;
  fill_KKT();
  ldl_factor();
  fillrhs_start();
  /* Borrow work.lhs_aff for the solution. */
  ldl_solve(work.rhs, work.lhs_aff);
  /* Don't do any refinement for now. Precision doesn't matter too much. */
  x = work.lhs_aff;
  s = work.lhs_aff + 159;
  z = work.lhs_aff + 259;
  y = work.lhs_aff + 359;
  /* Just set x and y as is. */
  for (i = 0; i < 159; i++)
    work.x[i] = x[i];
  for (i = 0; i < 139; i++)
    work.y[i] = y[i];
  /* Now complete the initialization. Start with s. */
  /* Must have alpha > max(z). */
  alpha = -1e99;
  for (i = 0; i < 100; i++)
    if (alpha < z[i])
      alpha = z[i];
  if (alpha < 0) {
    for (i = 0; i < 100; i++)
      work.s[i] = -z[i];
  } else {
    alpha += 1;
    for (i = 0; i < 100; i++)
      work.s[i] = -z[i] + alpha;
  }
  /* Now initialize z. */
  /* Now must have alpha > max(-z). */
  alpha = -1e99;
  for (i = 0; i < 100; i++)
    if (alpha < -z[i])
      alpha = -z[i];
  if (alpha < 0) {
    for (i = 0; i < 100; i++)
      work.z[i] = z[i];
  } else {
    alpha += 1;
    for (i = 0; i < 100; i++)
      work.z[i] = z[i] + alpha;
  }
}
void fillrhs_start(void) {
  /* Fill rhs with (-q, 0, h, b). */
  int i;
  double *r1, *r2, *r3, *r4;
  r1 = work.rhs;
  r2 = work.rhs + 159;
  r3 = work.rhs + 259;
  r4 = work.rhs + 359;
  for (i = 0; i < 159; i++)
    r1[i] = -work.q[i];
  for (i = 0; i < 100; i++)
    r2[i] = 0;
  for (i = 0; i < 100; i++)
    r3[i] = work.h[i];
  for (i = 0; i < 139; i++)
    r4[i] = work.b[i];
}
long solve(void) {
  int i;
  int iter;
  double *dx, *ds, *dy, *dz;
  double minval;
  double alpha;
  work.converged = 0;
  setup_pointers();
  pre_ops();
#ifndef ZERO_LIBRARY_MODE
  if (settings.verbose)
    printf("iter     objv        gap       |Ax-b|    |Gx+s-h|    step\n");
#endif
  fillq();
  fillh();
  fillb();
  if (settings.better_start)
    better_start();
  else
    set_start();
  for (iter = 0; iter < settings.max_iters; iter++) {
    for (i = 0; i < 100; i++) {
      work.s_inv[i] = 1.0 / work.s[i];
      work.s_inv_z[i] = work.s_inv[i]*work.z[i];
    }
    work.block_33[0] = 0;
    fill_KKT();
    ldl_factor();
    /* Affine scaling directions. */
    fillrhs_aff();
    ldl_solve(work.rhs, work.lhs_aff);
    refine(work.rhs, work.lhs_aff);
    /* Centering plus corrector directions. */
    fillrhs_cc();
    ldl_solve(work.rhs, work.lhs_cc);
    refine(work.rhs, work.lhs_cc);
    /* Add the two together and store in aff. */
    for (i = 0; i < 498; i++)
      work.lhs_aff[i] += work.lhs_cc[i];
    /* Rename aff to reflect its new meaning. */
    dx = work.lhs_aff;
    ds = work.lhs_aff + 159;
    dz = work.lhs_aff + 259;
    dy = work.lhs_aff + 359;
    /* Find min(min(ds./s), min(dz./z)). */
    minval = 0;
    for (i = 0; i < 100; i++)
      if (ds[i] < minval*work.s[i])
        minval = ds[i]/work.s[i];
    for (i = 0; i < 100; i++)
      if (dz[i] < minval*work.z[i])
        minval = dz[i]/work.z[i];
    /* Find alpha. */
    if (-0.99 < minval)
      alpha = 1;
    else
      alpha = -0.99/minval;
    /* Update the primal and dual variables. */
    for (i = 0; i < 159; i++)
      work.x[i] += alpha*dx[i];
    for (i = 0; i < 100; i++)
      work.s[i] += alpha*ds[i];
    for (i = 0; i < 100; i++)
      work.z[i] += alpha*dz[i];
    for (i = 0; i < 139; i++)
      work.y[i] += alpha*dy[i];
    work.gap = eval_gap();
    work.eq_resid_squared = calc_eq_resid_squared();
    work.ineq_resid_squared = calc_ineq_resid_squared();
#ifndef ZERO_LIBRARY_MODE
    if (settings.verbose) {
      work.optval = eval_objv();
      printf("%3d   %10.3e  %9.2e  %9.2e  %9.2e  % 6.4f\n",
          iter+1, work.optval, work.gap, sqrt(work.eq_resid_squared),
          sqrt(work.ineq_resid_squared), alpha);
    }
#endif
    /* Test termination conditions. Requires optimality, and satisfied */
    /* constraints. */
    if (   (work.gap < settings.eps)
        && (work.eq_resid_squared <= settings.resid_tol*settings.resid_tol)
        && (work.ineq_resid_squared <= settings.resid_tol*settings.resid_tol)
       ) {
      work.converged = 1;
      work.optval = eval_objv();
      return iter+1;
    }
  }
  return iter;
}
#include <time.h>
#include <stdlib.h>
#include <math.h>
long global_seed = 1;
static clock_t tic_timestart;
void tic(void) {
  tic_timestart = clock();
}
float toc(void) {
  clock_t tic_timestop;
  tic_timestop = clock();
  printf("time: %8.2f.\n", (float)(tic_timestop - tic_timestart) / CLOCKS_PER_SEC);
  return (float)(tic_timestop - tic_timestart) / CLOCKS_PER_SEC;
}
float tocq(void) {
  clock_t tic_timestop;
  tic_timestop = clock();
  return (float)(tic_timestop - tic_timestart) / CLOCKS_PER_SEC;
}
void printmatrix(char *name, double *A, int m, int n, int sparse) {
  int i, j;
  printf("%s = [...\n", name);
  for (i = 0; i < m; i++) {
    for (j = 0; j < n; j++)
      if ((sparse == 1) && (A[i+j*m] == 0))
        printf("         0");
      else
        printf("  % 9.4f", A[i+j*m]);
    printf(",\n");
  }
  printf("];\n");
}
double unif(double lower, double upper) {
  return lower + ((upper - lower)*rand())/RAND_MAX;
}
/* Next function is from numerical recipes in C. */
#define IA 16807
#define IM 2147483647
#define AM (1.0/IM)
#define IQ 127773
#define IR 2836
#define NTAB 32
#define NDIV (1+(IM-1)/NTAB)
#define EPS 1.2e-7
#define RNMX (1.0-EPS)
float ran1(long*idum, int reset) {
  int j;
  long k;
  static long iy=0;
  static long iv[NTAB];
  float temp;
  if (reset) {
    iy = 0;
  }
  if (*idum<=0||!iy) {
    if (-(*idum)<1)*idum=1;
    else *idum=-(*idum);
    for (j=NTAB+7; j>=0; j--) {
      k = (*idum)/IQ;
      *idum=IA*(*idum-k*IQ)-IR*k;
      if (*idum<0)*idum+=IM;
      if (j<NTAB)iv[j]=*idum;
    }
    iy = iv[0];
  }
  k = (*idum)/IQ;
  *idum = IA*(*idum-k*IQ)-IR*k;
  if (*idum<0)*idum += IM;
  j = iy/NDIV;
  iy = iv[j];
  iv[j] = *idum;
  if ((temp=AM*iy)> RNMX) return RNMX;
  else return temp;
}
/* Next function is from numerical recipes in C. */
float randn_internal(long *idum, int reset) {
  static int iset=0;
  static float gset;
  float fac, rsq, v1, v2;
  if (reset) {
    iset = 0;
  }
  if (iset==0) {
    do {
      v1 = 2.0*ran1(idum, reset)-1.0;
      v2 = 2.0*ran1(idum, reset)-1.0;
      rsq = v1*v1+v2*v2;
    } while(rsq >= 1.0 || rsq == 0.0);
    fac = sqrt(-2.0*log(rsq)/rsq);
    gset = v1*fac;
    iset = 1;
    return v2*fac;
  } else {
    iset = 0;
    return gset;
  }
}
double randn(void) {
  return randn_internal(&global_seed, 0);
}
void reset_rand(void) {
  srand(15);
  global_seed = 1;
  randn_internal(&global_seed, 1);
}
/* Be sure to place ldl_solve first, so storage schemes are defined by it. */
void ldl_solve(double *target, double *var) {
  int i;
  /* Find var = (L*diag(work.d)*L') \ target, then unpermute. */
  /* Answer goes into var. */
  /* Forward substitution. */
  /* Include permutation as we retrieve from target. Use v so we can unpermute */
  /* later. */
  work.v[0] = target[159];
  work.v[1] = target[160];
  work.v[2] = target[161];
  work.v[3] = target[162];
  work.v[4] = target[163];
  work.v[5] = target[164];
  work.v[6] = target[165];
  work.v[7] = target[166];
  work.v[8] = target[167];
  work.v[9] = target[168];
  work.v[10] = target[169];
  work.v[11] = target[170];
  work.v[12] = target[171];
  work.v[13] = target[172];
  work.v[14] = target[173];
  work.v[15] = target[174];
  work.v[16] = target[175];
  work.v[17] = target[176];
  work.v[18] = target[177];
  work.v[19] = target[178];
  work.v[20] = target[179];
  work.v[21] = target[180];
  work.v[22] = target[181];
  work.v[23] = target[182];
  work.v[24] = target[183];
  work.v[25] = target[184];
  work.v[26] = target[185];
  work.v[27] = target[186];
  work.v[28] = target[187];
  work.v[29] = target[188];
  work.v[30] = target[189];
  work.v[31] = target[190];
  work.v[32] = target[191];
  work.v[33] = target[192];
  work.v[34] = target[193];
  work.v[35] = target[194];
  work.v[36] = target[195];
  work.v[37] = target[196];
  work.v[38] = target[197];
  work.v[39] = target[198];
  work.v[40] = target[199];
  work.v[41] = target[200];
  work.v[42] = target[201];
  work.v[43] = target[202];
  work.v[44] = target[203];
  work.v[45] = target[204];
  work.v[46] = target[205];
  work.v[47] = target[206];
  work.v[48] = target[207];
  work.v[49] = target[208];
  work.v[50] = target[209];
  work.v[51] = target[210];
  work.v[52] = target[211];
  work.v[53] = target[212];
  work.v[54] = target[213];
  work.v[55] = target[214];
  work.v[56] = target[215];
  work.v[57] = target[216];
  work.v[58] = target[217];
  work.v[59] = target[218];
  work.v[60] = target[219];
  work.v[61] = target[220];
  work.v[62] = target[221];
  work.v[63] = target[222];
  work.v[64] = target[223];
  work.v[65] = target[224];
  work.v[66] = target[225];
  work.v[67] = target[226];
  work.v[68] = target[227];
  work.v[69] = target[228];
  work.v[70] = target[229];
  work.v[71] = target[230];
  work.v[72] = target[231];
  work.v[73] = target[232];
  work.v[74] = target[233];
  work.v[75] = target[234];
  work.v[76] = target[235];
  work.v[77] = target[236];
  work.v[78] = target[237];
  work.v[79] = target[238];
  work.v[80] = target[239];
  work.v[81] = target[240];
  work.v[82] = target[241];
  work.v[83] = target[242];
  work.v[84] = target[243];
  work.v[85] = target[244];
  work.v[86] = target[245];
  work.v[87] = target[246];
  work.v[88] = target[247];
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
  work.v[386] = target[391]-work.L[326]*work.v[292]-work.L[327]*work.v[293]-work.L[328]*work.v[383]-work.L[329]*work.v[385];
  work.v[387] = target[392]-work.L[330]*work.v[293]-work.L[331]*work.v[384]-work.L[332]*work.v[385]-work.L[333]*work.v[386];
  work.v[388] = target[153]-work.L[334]*work.v[257];
  work.v[389] = target[154];
  work.v[390] = target[495]-work.L[335]*work.v[388]-work.L[336]*work.v[389];
  work.v[391] = target[393]-work.L[337]*work.v[294]-work.L[338]*work.v[295]-work.L[339]*work.v[388]-work.L[340]*work.v[390];
  work.v[392] = target[394]-work.L[341]*work.v[295]-work.L[342]*work.v[389]-work.L[343]*work.v[390]-work.L[344]*work.v[391];
  work.v[393] = target[155]-work.L[345]*work.v[258];
  work.v[394] = target[156];
  work.v[395] = target[496]-work.L[346]*work.v[393]-work.L[347]*work.v[394];
  work.v[396] = target[395]-work.L[348]*work.v[296]-work.L[349]*work.v[297]-work.L[350]*work.v[393]-work.L[351]*work.v[395];
  work.v[397] = target[396]-work.L[352]*work.v[297]-work.L[353]*work.v[394]-work.L[354]*work.v[395]-work.L[355]*work.v[396];
  work.v[398] = target[157]-work.L[356]*work.v[259];
  work.v[399] = target[158];
  work.v[400] = target[497]-work.L[357]*work.v[398]-work.L[358]*work.v[399];
  work.v[401] = target[397]-work.L[359]*work.v[298]-work.L[360]*work.v[299]-work.L[361]*work.v[300]-work.L[362]*work.v[398]-work.L[363]*work.v[400];
  work.v[402] = target[398]-work.L[364]*work.v[299]-work.L[365]*work.v[301]-work.L[366]*work.v[399]-work.L[367]*work.v[400]-work.L[368]*work.v[401];
  work.v[403] = target[78]-work.L[369]*work.v[217]-work.L[370]*work.v[218]-work.L[371]*work.v[237];
  work.v[404] = target[456]-work.L[372]*work.v[300]-work.L[373]*work.v[401]-work.L[374]*work.v[402]-work.L[375]*work.v[403];
  work.v[405] = target[457]-work.L[376]*work.v[301]-work.L[377]*work.v[402]-work.L[378]*work.v[403]-work.L[379]*work.v[404];
  work.v[406] = target[115]-work.L[380]*work.v[157]-work.L[381]*work.v[158]-work.L[382]*work.v[396]-work.L[383]*work.v[397]-work.L[384]*work.v[404]-work.L[385]*work.v[405];
  work.v[407] = target[116]-work.L[386]*work.v[179]-work.L[387]*work.v[397]-work.L[388]*work.v[404]-work.L[389]*work.v[405]-work.L[390]*work.v[406];
  work.v[408] = target[77]-work.L[391]*work.v[215]-work.L[392]*work.v[216]-work.L[393]*work.v[236]-work.L[394]*work.v[237]-work.L[395]*work.v[403]-work.L[396]*work.v[404]-work.L[397]*work.v[405]-work.L[398]*work.v[406]-work.L[399]*work.v[407];
  work.v[409] = target[454]-work.L[400]*work.v[406]-work.L[401]*work.v[407]-work.L[402]*work.v[408];
  work.v[410] = target[455]-work.L[403]*work.v[407]-work.L[404]*work.v[408]-work.L[405]*work.v[409];
  work.v[411] = target[113]-work.L[406]*work.v[155]-work.L[407]*work.v[156]-work.L[408]*work.v[391]-work.L[409]*work.v[392]-work.L[410]*work.v[409]-work.L[411]*work.v[410];
  work.v[412] = target[114]-work.L[412]*work.v[178]-work.L[413]*work.v[392]-work.L[414]*work.v[409]-work.L[415]*work.v[410]-work.L[416]*work.v[411];
  work.v[413] = target[76]-work.L[417]*work.v[213]-work.L[418]*work.v[214]-work.L[419]*work.v[235]-work.L[420]*work.v[236]-work.L[421]*work.v[408]-work.L[422]*work.v[409]-work.L[423]*work.v[410]-work.L[424]*work.v[411]-work.L[425]*work.v[412];
  work.v[414] = target[452]-work.L[426]*work.v[411]-work.L[427]*work.v[412]-work.L[428]*work.v[413];
  work.v[415] = target[453]-work.L[429]*work.v[412]-work.L[430]*work.v[413]-work.L[431]*work.v[414];
  work.v[416] = target[111]-work.L[432]*work.v[153]-work.L[433]*work.v[154]-work.L[434]*work.v[386]-work.L[435]*work.v[387]-work.L[436]*work.v[414]-work.L[437]*work.v[415];
  work.v[417] = target[112]-work.L[438]*work.v[177]-work.L[439]*work.v[387]-work.L[440]*work.v[414]-work.L[441]*work.v[415]-work.L[442]*work.v[416];
  work.v[418] = target[75]-work.L[443]*work.v[211]-work.L[444]*work.v[212]-work.L[445]*work.v[234]-work.L[446]*work.v[235]-work.L[447]*work.v[413]-work.L[448]*work.v[414]-work.L[449]*work.v[415]-work.L[450]*work.v[416]-work.L[451]*work.v[417];
  work.v[419] = target[450]-work.L[452]*work.v[416]-work.L[453]*work.v[417]-work.L[454]*work.v[418];
  work.v[420] = target[451]-work.L[455]*work.v[417]-work.L[456]*work.v[418]-work.L[457]*work.v[419];
  work.v[421] = target[109]-work.L[458]*work.v[151]-work.L[459]*work.v[152]-work.L[460]*work.v[381]-work.L[461]*work.v[382]-work.L[462]*work.v[419]-work.L[463]*work.v[420];
  work.v[422] = target[110]-work.L[464]*work.v[176]-work.L[465]*work.v[382]-work.L[466]*work.v[419]-work.L[467]*work.v[420]-work.L[468]*work.v[421];
  work.v[423] = target[74]-work.L[469]*work.v[209]-work.L[470]*work.v[210]-work.L[471]*work.v[233]-work.L[472]*work.v[234]-work.L[473]*work.v[418]-work.L[474]*work.v[419]-work.L[475]*work.v[420]-work.L[476]*work.v[421]-work.L[477]*work.v[422];
  work.v[424] = target[448]-work.L[478]*work.v[421]-work.L[479]*work.v[422]-work.L[480]*work.v[423];
  work.v[425] = target[449]-work.L[481]*work.v[422]-work.L[482]*work.v[423]-work.L[483]*work.v[424];
  work.v[426] = target[107]-work.L[484]*work.v[149]-work.L[485]*work.v[150]-work.L[486]*work.v[376]-work.L[487]*work.v[377]-work.L[488]*work.v[424]-work.L[489]*work.v[425];
  work.v[427] = target[108]-work.L[490]*work.v[175]-work.L[491]*work.v[377]-work.L[492]*work.v[424]-work.L[493]*work.v[425]-work.L[494]*work.v[426];
  work.v[428] = target[73]-work.L[495]*work.v[207]-work.L[496]*work.v[208]-work.L[497]*work.v[232]-work.L[498]*work.v[233]-work.L[499]*work.v[423]-work.L[500]*work.v[424]-work.L[501]*work.v[425]-work.L[502]*work.v[426]-work.L[503]*work.v[427];
  work.v[429] = target[446]-work.L[504]*work.v[426]-work.L[505]*work.v[427]-work.L[506]*work.v[428];
  work.v[430] = target[447]-work.L[507]*work.v[427]-work.L[508]*work.v[428]-work.L[509]*work.v[429];
  work.v[431] = target[105]-work.L[510]*work.v[147]-work.L[511]*work.v[148]-work.L[512]*work.v[371]-work.L[513]*work.v[372]-work.L[514]*work.v[429]-work.L[515]*work.v[430];
  work.v[432] = target[106]-work.L[516]*work.v[174]-work.L[517]*work.v[372]-work.L[518]*work.v[429]-work.L[519]*work.v[430]-work.L[520]*work.v[431];
  work.v[433] = target[72]-work.L[521]*work.v[205]-work.L[522]*work.v[206]-work.L[523]*work.v[231]-work.L[524]*work.v[232]-work.L[525]*work.v[428]-work.L[526]*work.v[429]-work.L[527]*work.v[430]-work.L[528]*work.v[431]-work.L[529]*work.v[432];
  work.v[434] = target[444]-work.L[530]*work.v[431]-work.L[531]*work.v[432]-work.L[532]*work.v[433];
  work.v[435] = target[445]-work.L[533]*work.v[432]-work.L[534]*work.v[433]-work.L[535]*work.v[434];
  work.v[436] = target[103]-work.L[536]*work.v[145]-work.L[537]*work.v[146]-work.L[538]*work.v[366]-work.L[539]*work.v[367]-work.L[540]*work.v[434]-work.L[541]*work.v[435];
  work.v[437] = target[104]-work.L[542]*work.v[173]-work.L[543]*work.v[367]-work.L[544]*work.v[434]-work.L[545]*work.v[435]-work.L[546]*work.v[436];
  work.v[438] = target[71]-work.L[547]*work.v[203]-work.L[548]*work.v[204]-work.L[549]*work.v[230]-work.L[550]*work.v[231]-work.L[551]*work.v[433]-work.L[552]*work.v[434]-work.L[553]*work.v[435]-work.L[554]*work.v[436]-work.L[555]*work.v[437];
  work.v[439] = target[442]-work.L[556]*work.v[436]-work.L[557]*work.v[437]-work.L[558]*work.v[438];
  work.v[440] = target[443]-work.L[559]*work.v[437]-work.L[560]*work.v[438]-work.L[561]*work.v[439];
  work.v[441] = target[101]-work.L[562]*work.v[143]-work.L[563]*work.v[144]-work.L[564]*work.v[361]-work.L[565]*work.v[362]-work.L[566]*work.v[439]-work.L[567]*work.v[440];
  work.v[442] = target[102]-work.L[568]*work.v[172]-work.L[569]*work.v[362]-work.L[570]*work.v[439]-work.L[571]*work.v[440]-work.L[572]*work.v[441];
  work.v[443] = target[70]-work.L[573]*work.v[201]-work.L[574]*work.v[202]-work.L[575]*work.v[229]-work.L[576]*work.v[230]-work.L[577]*work.v[438]-work.L[578]*work.v[439]-work.L[579]*work.v[440]-work.L[580]*work.v[441]-work.L[581]*work.v[442];
  work.v[444] = target[440]-work.L[582]*work.v[441]-work.L[583]*work.v[442]-work.L[584]*work.v[443];
  work.v[445] = target[441]-work.L[585]*work.v[442]-work.L[586]*work.v[443]-work.L[587]*work.v[444];
  work.v[446] = target[99]-work.L[588]*work.v[141]-work.L[589]*work.v[142]-work.L[590]*work.v[356]-work.L[591]*work.v[357]-work.L[592]*work.v[444]-work.L[593]*work.v[445];
  work.v[447] = target[100]-work.L[594]*work.v[171]-work.L[595]*work.v[357]-work.L[596]*work.v[444]-work.L[597]*work.v[445]-work.L[598]*work.v[446];
  work.v[448] = target[69]-work.L[599]*work.v[199]-work.L[600]*work.v[200]-work.L[601]*work.v[228]-work.L[602]*work.v[229]-work.L[603]*work.v[443]-work.L[604]*work.v[444]-work.L[605]*work.v[445]-work.L[606]*work.v[446]-work.L[607]*work.v[447];
  work.v[449] = target[438]-work.L[608]*work.v[446]-work.L[609]*work.v[447]-work.L[610]*work.v[448];
  work.v[450] = target[439]-work.L[611]*work.v[447]-work.L[612]*work.v[448]-work.L[613]*work.v[449];
  work.v[451] = target[97]-work.L[614]*work.v[139]-work.L[615]*work.v[140]-work.L[616]*work.v[351]-work.L[617]*work.v[352]-work.L[618]*work.v[449]-work.L[619]*work.v[450];
  work.v[452] = target[98]-work.L[620]*work.v[170]-work.L[621]*work.v[352]-work.L[622]*work.v[449]-work.L[623]*work.v[450]-work.L[624]*work.v[451];
  work.v[453] = target[68]-work.L[625]*work.v[197]-work.L[626]*work.v[198]-work.L[627]*work.v[227]-work.L[628]*work.v[228]-work.L[629]*work.v[448]-work.L[630]*work.v[449]-work.L[631]*work.v[450]-work.L[632]*work.v[451]-work.L[633]*work.v[452];
  work.v[454] = target[436]-work.L[634]*work.v[451]-work.L[635]*work.v[452]-work.L[636]*work.v[453];
  work.v[455] = target[437]-work.L[637]*work.v[452]-work.L[638]*work.v[453]-work.L[639]*work.v[454];
  work.v[456] = target[95]-work.L[640]*work.v[137]-work.L[641]*work.v[138]-work.L[642]*work.v[346]-work.L[643]*work.v[347]-work.L[644]*work.v[454]-work.L[645]*work.v[455];
  work.v[457] = target[96]-work.L[646]*work.v[169]-work.L[647]*work.v[347]-work.L[648]*work.v[454]-work.L[649]*work.v[455]-work.L[650]*work.v[456];
  work.v[458] = target[67]-work.L[651]*work.v[195]-work.L[652]*work.v[196]-work.L[653]*work.v[226]-work.L[654]*work.v[227]-work.L[655]*work.v[453]-work.L[656]*work.v[454]-work.L[657]*work.v[455]-work.L[658]*work.v[456]-work.L[659]*work.v[457];
  work.v[459] = target[434]-work.L[660]*work.v[456]-work.L[661]*work.v[457]-work.L[662]*work.v[458];
  work.v[460] = target[435]-work.L[663]*work.v[457]-work.L[664]*work.v[458]-work.L[665]*work.v[459];
  work.v[461] = target[93]-work.L[666]*work.v[135]-work.L[667]*work.v[136]-work.L[668]*work.v[341]-work.L[669]*work.v[342]-work.L[670]*work.v[459]-work.L[671]*work.v[460];
  work.v[462] = target[94]-work.L[672]*work.v[168]-work.L[673]*work.v[342]-work.L[674]*work.v[459]-work.L[675]*work.v[460]-work.L[676]*work.v[461];
  work.v[463] = target[66]-work.L[677]*work.v[193]-work.L[678]*work.v[194]-work.L[679]*work.v[225]-work.L[680]*work.v[226]-work.L[681]*work.v[458]-work.L[682]*work.v[459]-work.L[683]*work.v[460]-work.L[684]*work.v[461]-work.L[685]*work.v[462];
  work.v[464] = target[432]-work.L[686]*work.v[461]-work.L[687]*work.v[462]-work.L[688]*work.v[463];
  work.v[465] = target[433]-work.L[689]*work.v[462]-work.L[690]*work.v[463]-work.L[691]*work.v[464];
  work.v[466] = target[91]-work.L[692]*work.v[133]-work.L[693]*work.v[134]-work.L[694]*work.v[336]-work.L[695]*work.v[337]-work.L[696]*work.v[464]-work.L[697]*work.v[465];
  work.v[467] = target[92]-work.L[698]*work.v[167]-work.L[699]*work.v[337]-work.L[700]*work.v[464]-work.L[701]*work.v[465]-work.L[702]*work.v[466];
  work.v[468] = target[65]-work.L[703]*work.v[191]-work.L[704]*work.v[192]-work.L[705]*work.v[224]-work.L[706]*work.v[225]-work.L[707]*work.v[463]-work.L[708]*work.v[464]-work.L[709]*work.v[465]-work.L[710]*work.v[466]-work.L[711]*work.v[467];
  work.v[469] = target[430]-work.L[712]*work.v[466]-work.L[713]*work.v[467]-work.L[714]*work.v[468];
  work.v[470] = target[431]-work.L[715]*work.v[467]-work.L[716]*work.v[468]-work.L[717]*work.v[469];
  work.v[471] = target[89]-work.L[718]*work.v[131]-work.L[719]*work.v[132]-work.L[720]*work.v[331]-work.L[721]*work.v[332]-work.L[722]*work.v[469]-work.L[723]*work.v[470];
  work.v[472] = target[90]-work.L[724]*work.v[166]-work.L[725]*work.v[332]-work.L[726]*work.v[469]-work.L[727]*work.v[470]-work.L[728]*work.v[471];
  work.v[473] = target[64]-work.L[729]*work.v[189]-work.L[730]*work.v[190]-work.L[731]*work.v[223]-work.L[732]*work.v[224]-work.L[733]*work.v[468]-work.L[734]*work.v[469]-work.L[735]*work.v[470]-work.L[736]*work.v[471]-work.L[737]*work.v[472];
  work.v[474] = target[428]-work.L[738]*work.v[471]-work.L[739]*work.v[472]-work.L[740]*work.v[473];
  work.v[475] = target[429]-work.L[741]*work.v[472]-work.L[742]*work.v[473]-work.L[743]*work.v[474];
  work.v[476] = target[87]-work.L[744]*work.v[129]-work.L[745]*work.v[130]-work.L[746]*work.v[326]-work.L[747]*work.v[327]-work.L[748]*work.v[474]-work.L[749]*work.v[475];
  work.v[477] = target[88]-work.L[750]*work.v[165]-work.L[751]*work.v[327]-work.L[752]*work.v[474]-work.L[753]*work.v[475]-work.L[754]*work.v[476];
  work.v[478] = target[63]-work.L[755]*work.v[187]-work.L[756]*work.v[188]-work.L[757]*work.v[222]-work.L[758]*work.v[223]-work.L[759]*work.v[473]-work.L[760]*work.v[474]-work.L[761]*work.v[475]-work.L[762]*work.v[476]-work.L[763]*work.v[477];
  work.v[479] = target[426]-work.L[764]*work.v[476]-work.L[765]*work.v[477]-work.L[766]*work.v[478];
  work.v[480] = target[427]-work.L[767]*work.v[477]-work.L[768]*work.v[478]-work.L[769]*work.v[479];
  work.v[481] = target[85]-work.L[770]*work.v[127]-work.L[771]*work.v[128]-work.L[772]*work.v[321]-work.L[773]*work.v[322]-work.L[774]*work.v[479]-work.L[775]*work.v[480];
  work.v[482] = target[86]-work.L[776]*work.v[164]-work.L[777]*work.v[322]-work.L[778]*work.v[479]-work.L[779]*work.v[480]-work.L[780]*work.v[481];
  work.v[483] = target[62]-work.L[781]*work.v[185]-work.L[782]*work.v[186]-work.L[783]*work.v[221]-work.L[784]*work.v[222]-work.L[785]*work.v[478]-work.L[786]*work.v[479]-work.L[787]*work.v[480]-work.L[788]*work.v[481]-work.L[789]*work.v[482];
  work.v[484] = target[424]-work.L[790]*work.v[481]-work.L[791]*work.v[482]-work.L[792]*work.v[483];
  work.v[485] = target[425]-work.L[793]*work.v[482]-work.L[794]*work.v[483]-work.L[795]*work.v[484];
  work.v[486] = target[83]-work.L[796]*work.v[125]-work.L[797]*work.v[126]-work.L[798]*work.v[316]-work.L[799]*work.v[317]-work.L[800]*work.v[484]-work.L[801]*work.v[485];
  work.v[487] = target[84]-work.L[802]*work.v[163]-work.L[803]*work.v[317]-work.L[804]*work.v[484]-work.L[805]*work.v[485]-work.L[806]*work.v[486];
  work.v[488] = target[61]-work.L[807]*work.v[183]-work.L[808]*work.v[184]-work.L[809]*work.v[220]-work.L[810]*work.v[221]-work.L[811]*work.v[483]-work.L[812]*work.v[484]-work.L[813]*work.v[485]-work.L[814]*work.v[486]-work.L[815]*work.v[487];
  work.v[489] = target[422]-work.L[816]*work.v[486]-work.L[817]*work.v[487]-work.L[818]*work.v[488];
  work.v[490] = target[423]-work.L[819]*work.v[487]-work.L[820]*work.v[488]-work.L[821]*work.v[489];
  work.v[491] = target[81]-work.L[822]*work.v[123]-work.L[823]*work.v[124]-work.L[824]*work.v[311]-work.L[825]*work.v[312]-work.L[826]*work.v[489]-work.L[827]*work.v[490];
  work.v[492] = target[79]-work.L[828]*work.v[121]-work.L[829]*work.v[122]-work.L[830]*work.v[238]-work.L[831]*work.v[305]-work.L[832]*work.v[306]-work.L[833]*work.v[307];
  work.v[493] = target[80]-work.L[834]*work.v[161]-work.L[835]*work.v[239]-work.L[836]*work.v[306]-work.L[837]*work.v[307]-work.L[838]*work.v[492];
  work.v[494] = target[60]-work.L[839]*work.v[181]-work.L[840]*work.v[182]-work.L[841]*work.v[219]-work.L[842]*work.v[220]-work.L[843]*work.v[307]-work.L[844]*work.v[488]-work.L[845]*work.v[489]-work.L[846]*work.v[490]-work.L[847]*work.v[491]-work.L[848]*work.v[492]-work.L[849]*work.v[493];
  work.v[495] = target[82]-work.L[850]*work.v[162]-work.L[851]*work.v[312]-work.L[852]*work.v[489]-work.L[853]*work.v[490]-work.L[854]*work.v[491]-work.L[855]*work.v[494];
  work.v[496] = target[420]-work.L[856]*work.v[491]-work.L[857]*work.v[492]-work.L[858]*work.v[493]-work.L[859]*work.v[494]-work.L[860]*work.v[495];
  work.v[497] = target[421]-work.L[861]*work.v[492]-work.L[862]*work.v[493]-work.L[863]*work.v[494]-work.L[864]*work.v[495]-work.L[865]*work.v[496];
  /* Diagonal scaling. Assume correctness of work.d_inv. */
  for (i = 0; i < 498; i++)
    work.v[i] *= work.d_inv[i];
  /* Back substitution */
  work.v[496] -= work.L[865]*work.v[497];
  work.v[495] -= work.L[860]*work.v[496]+work.L[864]*work.v[497];
  work.v[494] -= work.L[855]*work.v[495]+work.L[859]*work.v[496]+work.L[863]*work.v[497];
  work.v[493] -= work.L[849]*work.v[494]+work.L[858]*work.v[496]+work.L[862]*work.v[497];
  work.v[492] -= work.L[838]*work.v[493]+work.L[848]*work.v[494]+work.L[857]*work.v[496]+work.L[861]*work.v[497];
  work.v[491] -= work.L[847]*work.v[494]+work.L[854]*work.v[495]+work.L[856]*work.v[496];
  work.v[490] -= work.L[827]*work.v[491]+work.L[846]*work.v[494]+work.L[853]*work.v[495];
  work.v[489] -= work.L[821]*work.v[490]+work.L[826]*work.v[491]+work.L[845]*work.v[494]+work.L[852]*work.v[495];
  work.v[488] -= work.L[818]*work.v[489]+work.L[820]*work.v[490]+work.L[844]*work.v[494];
  work.v[487] -= work.L[815]*work.v[488]+work.L[817]*work.v[489]+work.L[819]*work.v[490];
  work.v[486] -= work.L[806]*work.v[487]+work.L[814]*work.v[488]+work.L[816]*work.v[489];
  work.v[485] -= work.L[801]*work.v[486]+work.L[805]*work.v[487]+work.L[813]*work.v[488];
  work.v[484] -= work.L[795]*work.v[485]+work.L[800]*work.v[486]+work.L[804]*work.v[487]+work.L[812]*work.v[488];
  work.v[483] -= work.L[792]*work.v[484]+work.L[794]*work.v[485]+work.L[811]*work.v[488];
  work.v[482] -= work.L[789]*work.v[483]+work.L[791]*work.v[484]+work.L[793]*work.v[485];
  work.v[481] -= work.L[780]*work.v[482]+work.L[788]*work.v[483]+work.L[790]*work.v[484];
  work.v[480] -= work.L[775]*work.v[481]+work.L[779]*work.v[482]+work.L[787]*work.v[483];
  work.v[479] -= work.L[769]*work.v[480]+work.L[774]*work.v[481]+work.L[778]*work.v[482]+work.L[786]*work.v[483];
  work.v[478] -= work.L[766]*work.v[479]+work.L[768]*work.v[480]+work.L[785]*work.v[483];
  work.v[477] -= work.L[763]*work.v[478]+work.L[765]*work.v[479]+work.L[767]*work.v[480];
  work.v[476] -= work.L[754]*work.v[477]+work.L[762]*work.v[478]+work.L[764]*work.v[479];
  work.v[475] -= work.L[749]*work.v[476]+work.L[753]*work.v[477]+work.L[761]*work.v[478];
  work.v[474] -= work.L[743]*work.v[475]+work.L[748]*work.v[476]+work.L[752]*work.v[477]+work.L[760]*work.v[478];
  work.v[473] -= work.L[740]*work.v[474]+work.L[742]*work.v[475]+work.L[759]*work.v[478];
  work.v[472] -= work.L[737]*work.v[473]+work.L[739]*work.v[474]+work.L[741]*work.v[475];
  work.v[471] -= work.L[728]*work.v[472]+work.L[736]*work.v[473]+work.L[738]*work.v[474];
  work.v[470] -= work.L[723]*work.v[471]+work.L[727]*work.v[472]+work.L[735]*work.v[473];
  work.v[469] -= work.L[717]*work.v[470]+work.L[722]*work.v[471]+work.L[726]*work.v[472]+work.L[734]*work.v[473];
  work.v[468] -= work.L[714]*work.v[469]+work.L[716]*work.v[470]+work.L[733]*work.v[473];
  work.v[467] -= work.L[711]*work.v[468]+work.L[713]*work.v[469]+work.L[715]*work.v[470];
  work.v[466] -= work.L[702]*work.v[467]+work.L[710]*work.v[468]+work.L[712]*work.v[469];
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
  var[493] = work.v[380];
  var[494] = work.v[385];
  var[495] = work.v[390];
  var[496] = work.v[395];
  var[497] = work.v[400];
#ifndef ZERO_LIBRARY_MODE
  if (settings.debug) {
    printf("Squared norm for solution is %.8g.\n", check_residual(target, var));
  }
#endif
}
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
