getc1995/Scaled-Robot-Cars/code/ubuntu/RC1/um_acc/src/ccsolver.cpp

/* Produced by CVXGEN, 2018-02-12 03:46:39 -0500.  */
/* CVXGEN is Copyright (C) 2006-2017 Jacob Mattingley, jem@cvxgen.com. */
/* The code in this file is Copyright (C) 2006-2017 Jacob Mattingley. */
/* CVXGEN, or solvers produced by CVXGEN, cannot be used for commercial */
/* applications without prior written permission from Jacob Mattingley. */

/* Filename: solver.c. */
/* Description: Main solver file. */
#include "ccsolver.h"
double eval_gap(void) {
  int i;
  double gap;
  gap = 0;
  for (i = 0; i < 40; i++)
    gap += work.z[i]*work.s[i];
  return gap;
}
void set_defaults(void) {
  settings.resid_tol = 1e-6;
  settings.eps = 1e-4;
  settings.max_iters = 25;
  settings.refine_steps = 1;
  settings.s_init = 1;
  settings.z_init = 1;
  settings.debug = 0;
  settings.verbose = 1;
  settings.verbose_refinement = 0;
  settings.better_start = 1;
  settings.kkt_reg = 1e-7;
}
void setup_pointers(void) {
  work.y = work.x + 59;
  work.s = work.x + 98;
  work.z = work.x + 138;
  vars.u_1 = work.x + 19;
  vars.u_2 = work.x + 20;
  vars.u_3 = work.x + 21;
  vars.u_4 = work.x + 22;
  vars.u_5 = work.x + 23;
  vars.u_6 = work.x + 24;
  vars.u_7 = work.x + 25;
  vars.u_8 = work.x + 26;
  vars.u_9 = work.x + 27;
  vars.u_10 = work.x + 28;
  vars.u_11 = work.x + 29;
  vars.u_12 = work.x + 30;
  vars.u_13 = work.x + 31;
  vars.u_14 = work.x + 32;
  vars.u_15 = work.x + 33;
  vars.u_16 = work.x + 34;
  vars.u_17 = work.x + 35;
  vars.u_18 = work.x + 36;
  vars.u_19 = work.x + 37;
  vars.u_20 = work.x + 38;
  vars.x_1 = work.x + 39;
  vars.x_2 = work.x + 40;
  vars.x_3 = work.x + 41;
  vars.x_4 = work.x + 42;
  vars.x_5 = work.x + 43;
  vars.x_6 = work.x + 44;
  vars.x_7 = work.x + 45;
  vars.x_8 = work.x + 46;
  vars.x_9 = work.x + 47;
  vars.x_10 = work.x + 48;
  vars.x_11 = work.x + 49;
  vars.x_12 = work.x + 50;
  vars.x_13 = work.x + 51;
  vars.x_14 = work.x + 52;
  vars.x_15 = work.x + 53;
  vars.x_16 = work.x + 54;
  vars.x_17 = work.x + 55;
  vars.x_18 = work.x + 56;
  vars.x_19 = work.x + 57;
  vars.x_20 = work.x + 58;
}
void setup_indexed_params(void) {
  /* In CVXGEN, you can say */
  /*   parameters */
  /*     A[i] (5,3), i=1..4 */
  /*   end */
  /* This function sets up A[2] to be a pointer to A_2, which is a length-15 */
  /* vector of doubles. */
  /* If you access parameters that you haven't defined in CVXGEN, the result */
  /* is undefined. */
  params.u[0] = params.u_0;
  params.x[0] = params.x_0;
}
void setup_indexed_optvars(void) {
  /* In CVXGEN, you can say */
  /*   variables */
  /*     x[i] (5), i=2..4 */
  /*   end */
  /* This function sets up x[3] to be a pointer to x_3, which is a length-5 */
  /* vector of doubles. */
  /* If you access variables that you haven't defined in CVXGEN, the result */
  /* is undefined. */
  vars.x[1] = vars.x_1;
  vars.x[2] = vars.x_2;
  vars.x[3] = vars.x_3;
  vars.x[4] = vars.x_4;
  vars.x[5] = vars.x_5;
  vars.x[6] = vars.x_6;
  vars.x[7] = vars.x_7;
  vars.x[8] = vars.x_8;
  vars.x[9] = vars.x_9;
  vars.x[10] = vars.x_10;
  vars.x[11] = vars.x_11;
  vars.x[12] = vars.x_12;
  vars.x[13] = vars.x_13;
  vars.x[14] = vars.x_14;
  vars.x[15] = vars.x_15;
  vars.x[16] = vars.x_16;
  vars.x[17] = vars.x_17;
  vars.x[18] = vars.x_18;
  vars.x[19] = vars.x_19;
  vars.x[20] = vars.x_20;
  vars.u[1] = vars.u_1;
  vars.u[2] = vars.u_2;
  vars.u[3] = vars.u_3;
  vars.u[4] = vars.u_4;
  vars.u[5] = vars.u_5;
  vars.u[6] = vars.u_6;
  vars.u[7] = vars.u_7;
  vars.u[8] = vars.u_8;
  vars.u[9] = vars.u_9;
  vars.u[10] = vars.u_10;
  vars.u[11] = vars.u_11;
  vars.u[12] = vars.u_12;
  vars.u[13] = vars.u_13;
  vars.u[14] = vars.u_14;
  vars.u[15] = vars.u_15;
  vars.u[16] = vars.u_16;
  vars.u[17] = vars.u_17;
  vars.u[18] = vars.u_18;
  vars.u[19] = vars.u_19;
  vars.u[20] = vars.u_20;
}
void setup_indexing(void) {
  setup_pointers();
  setup_indexed_params();
  setup_indexed_optvars();
}
void set_start(void) {
  int i;
  for (i = 0; i < 59; i++)
    work.x[i] = 0;
  for (i = 0; i < 39; i++)
    work.y[i] = 0;
  for (i = 0; i < 40; i++)
    work.s[i] = (work.h[i] > 0) ? work.h[i] : settings.s_init;
  for (i = 0; i < 40; i++)
    work.z[i] = settings.z_init;
}
double eval_objv(void) {
  int i;
  double objv;
  /* Borrow space in work.rhs. */
  multbyP(work.rhs, work.x);
  objv = 0;
  for (i = 0; i < 59; i++)
    objv += work.x[i]*work.rhs[i];
  objv *= 0.5;
  for (i = 0; i < 59; i++)
    objv += work.q[i]*work.x[i];
  objv += work.quad_261870821376[0]+work.quad_261870821376[0]+work.quad_261870821376[0]+work.quad_261870821376[0]+work.quad_261870821376[0]+work.quad_261870821376[0]+work.quad_261870821376[0]+work.quad_261870821376[0]+work.quad_261870821376[0]+work.quad_261870821376[0]+work.quad_261870821376[0]+work.quad_261870821376[0]+work.quad_261870821376[0]+work.quad_261870821376[0]+work.quad_261870821376[0]+work.quad_261870821376[0]+work.quad_261870821376[0]+work.quad_261870821376[0]+work.quad_261870821376[0]+work.quad_261870821376[0]+work.quad_397717204992[0];
  return objv;
}
void fillrhs_aff(void) {
  int i;
  double *r1, *r2, *r3, *r4;
  r1 = work.rhs;
  r2 = work.rhs + 59;
  r3 = work.rhs + 99;
  r4 = work.rhs + 139;
  /* r1 = -A^Ty - G^Tz - Px - q. */
  multbymAT(r1, work.y);
  multbymGT(work.buffer, work.z);
  for (i = 0; i < 59; i++)
    r1[i] += work.buffer[i];
  multbyP(work.buffer, work.x);
  for (i = 0; i < 59; i++)
    r1[i] -= work.buffer[i] + work.q[i];
  /* r2 = -z. */
  for (i = 0; i < 40; i++)
    r2[i] = -work.z[i];
  /* r3 = -Gx - s + h. */
  multbymG(r3, work.x);
  for (i = 0; i < 40; i++)
    r3[i] += -work.s[i] + work.h[i];
  /* r4 = -Ax + b. */
  multbymA(r4, work.x);
  for (i = 0; i < 39; i++)
    r4[i] += work.b[i];
}
void fillrhs_cc(void) {
  int i;
  double *r2;
  double *ds_aff, *dz_aff;
  double mu;
  double alpha;
  double sigma;
  double smu;
  double minval;
  r2 = work.rhs + 59;
  ds_aff = work.lhs_aff + 59;
  dz_aff = work.lhs_aff + 99;
  mu = 0;
  for (i = 0; i < 40; i++)
    mu += work.s[i]*work.z[i];
  /* Don't finish calculating mu quite yet. */
  /* Find min(min(ds./s), min(dz./z)). */
  minval = 0;
  for (i = 0; i < 40; i++)
    if (ds_aff[i] < minval*work.s[i])
      minval = ds_aff[i]/work.s[i];
  for (i = 0; i < 40; i++)
    if (dz_aff[i] < minval*work.z[i])
      minval = dz_aff[i]/work.z[i];
  /* Find alpha. */
  if (-1 < minval)
      alpha = 1;
  else
      alpha = -1/minval;
  sigma = 0;
  for (i = 0; i < 40; i++)
    sigma += (work.s[i] + alpha*ds_aff[i])*
      (work.z[i] + alpha*dz_aff[i]);
  sigma /= mu;
  sigma = sigma*sigma*sigma;
  /* Finish calculating mu now. */
  mu *= 0.025;
  smu = sigma*mu;
  /* Fill-in the rhs. */
  for (i = 0; i < 59; i++)
    work.rhs[i] = 0;
  for (i = 99; i < 178; i++)
    work.rhs[i] = 0;
  for (i = 0; i < 40; i++)
    r2[i] = work.s_inv[i]*(smu - ds_aff[i]*dz_aff[i]);
}
void refine(double *target, double *var) {
  int i, j;
  double *residual = work.buffer;
  double norm2;
  double *new_var = work.buffer2;
  for (j = 0; j < settings.refine_steps; j++) {
    norm2 = 0;
    matrix_multiply(residual, var);
    for (i = 0; i < 178; i++) {
      residual[i] = residual[i] - target[i];
      norm2 += residual[i]*residual[i];
    }
#ifndef ZERO_LIBRARY_MODE
    if (settings.verbose_refinement) {
      if (j == 0)
        printf("Initial residual before refinement has norm squared %.6g.\n", norm2);
      else
        printf("After refinement we get squared norm %.6g.\n", norm2);
    }
#endif
    /* Solve to find new_var = KKT \ (target - A*var). */
    ldl_solve(residual, new_var);
    /* Update var += new_var, or var += KKT \ (target - A*var). */
    for (i = 0; i < 178; i++) {
      var[i] -= new_var[i];
    }
  }
#ifndef ZERO_LIBRARY_MODE
  if (settings.verbose_refinement) {
    /* Check the residual once more, but only if we're reporting it, since */
    /* it's expensive. */
    norm2 = 0;
    matrix_multiply(residual, var);
    for (i = 0; i < 178; i++) {
      residual[i] = residual[i] - target[i];
      norm2 += residual[i]*residual[i];
    }
    if (j == 0)
      printf("Initial residual before refinement has norm squared %.6g.\n", norm2);
    else
      printf("After refinement we get squared norm %.6g.\n", norm2);
  }
#endif
}
double calc_ineq_resid_squared(void) {
  /* Calculates the norm ||-Gx - s + h||. */
  double norm2_squared;
  int i;
  /* Find -Gx. */
  multbymG(work.buffer, work.x);
  /* Add -s + h. */
  for (i = 0; i < 40; i++)
    work.buffer[i] += -work.s[i] + work.h[i];
  /* Now find the squared norm. */
  norm2_squared = 0;
  for (i = 0; i < 40; i++)
    norm2_squared += work.buffer[i]*work.buffer[i];
  return norm2_squared;
}
double calc_eq_resid_squared(void) {
  /* Calculates the norm ||-Ax + b||. */
  double norm2_squared;
  int i;
  /* Find -Ax. */
  multbymA(work.buffer, work.x);
  /* Add +b. */
  for (i = 0; i < 39; i++)
    work.buffer[i] += work.b[i];
  /* Now find the squared norm. */
  norm2_squared = 0;
  for (i = 0; i < 39; i++)
    norm2_squared += work.buffer[i]*work.buffer[i];
  return norm2_squared;
}
void better_start(void) {
  /* Calculates a better starting point, using a similar approach to CVXOPT. */
  /* Not yet speed optimized. */
  int i;
  double *x, *s, *z, *y;
  double alpha;
  work.block_33[0] = -1;
  /* Make sure sinvz is 1 to make hijacked KKT system ok. */
  for (i = 0; i < 40; i++)
    work.s_inv_z[i] = 1;
  fill_KKT();
  ldl_factor();
  fillrhs_start();
  /* Borrow work.lhs_aff for the solution. */
  ldl_solve(work.rhs, work.lhs_aff);
  /* Don't do any refinement for now. Precision doesn't matter too much. */
  x = work.lhs_aff;
  s = work.lhs_aff + 59;
  z = work.lhs_aff + 99;
  y = work.lhs_aff + 139;
  /* Just set x and y as is. */
  for (i = 0; i < 59; i++)
    work.x[i] = x[i];
  for (i = 0; i < 39; i++)
    work.y[i] = y[i];
  /* Now complete the initialization. Start with s. */
  /* Must have alpha > max(z). */
  alpha = -1e99;
  for (i = 0; i < 40; i++)
    if (alpha < z[i])
      alpha = z[i];
  if (alpha < 0) {
    for (i = 0; i < 40; i++)
      work.s[i] = -z[i];
  } else {
    alpha += 1;
    for (i = 0; i < 40; i++)
      work.s[i] = -z[i] + alpha;
  }
  /* Now initialize z. */
  /* Now must have alpha > max(-z). */
  alpha = -1e99;
  for (i = 0; i < 40; i++)
    if (alpha < -z[i])
      alpha = -z[i];
  if (alpha < 0) {
    for (i = 0; i < 40; i++)
      work.z[i] = z[i];
  } else {
    alpha += 1;
    for (i = 0; i < 40; i++)
      work.z[i] = z[i] + alpha;
  }
}
void fillrhs_start(void) {
  /* Fill rhs with (-q, 0, h, b). */
  int i;
  double *r1, *r2, *r3, *r4;
  r1 = work.rhs;
  r2 = work.rhs + 59;
  r3 = work.rhs + 99;
  r4 = work.rhs + 139;
  for (i = 0; i < 59; i++)
    r1[i] = -work.q[i];
  for (i = 0; i < 40; i++)
    r2[i] = 0;
  for (i = 0; i < 40; i++)
    r3[i] = work.h[i];
  for (i = 0; i < 39; i++)
    r4[i] = work.b[i];
}
long solve(void) {
  int i;
  int iter;
  double *dx, *ds, *dy, *dz;
  double minval;
  double alpha;
  work.converged = 0;
  setup_pointers();
  pre_ops();
#ifndef ZERO_LIBRARY_MODE
  if (settings.verbose)
    printf("iter     objv        gap       |Ax-b|    |Gx+s-h|    step\n");
#endif
  fillq();
  fillh();
  fillb();
  if (settings.better_start)
    better_start();
  else
    set_start();
  for (iter = 0; iter < settings.max_iters; iter++) {
    for (i = 0; i < 40; i++) {
      work.s_inv[i] = 1.0 / work.s[i];
      work.s_inv_z[i] = work.s_inv[i]*work.z[i];
    }
    work.block_33[0] = 0;
    fill_KKT();
    ldl_factor();
    /* Affine scaling directions. */
    fillrhs_aff();
    ldl_solve(work.rhs, work.lhs_aff);
    refine(work.rhs, work.lhs_aff);
    /* Centering plus corrector directions. */
    fillrhs_cc();
    ldl_solve(work.rhs, work.lhs_cc);
    refine(work.rhs, work.lhs_cc);
    /* Add the two together and store in aff. */
    for (i = 0; i < 178; i++)
      work.lhs_aff[i] += work.lhs_cc[i];
    /* Rename aff to reflect its new meaning. */
    dx = work.lhs_aff;
    ds = work.lhs_aff + 59;
    dz = work.lhs_aff + 99;
    dy = work.lhs_aff + 139;
    /* Find min(min(ds./s), min(dz./z)). */
    minval = 0;
    for (i = 0; i < 40; i++)
      if (ds[i] < minval*work.s[i])
        minval = ds[i]/work.s[i];
    for (i = 0; i < 40; i++)
      if (dz[i] < minval*work.z[i])
        minval = dz[i]/work.z[i];
    /* Find alpha. */
    if (-0.99 < minval)
      alpha = 1;
    else
      alpha = -0.99/minval;
    /* Update the primal and dual variables. */
    for (i = 0; i < 59; i++)
      work.x[i] += alpha*dx[i];
    for (i = 0; i < 40; i++)
      work.s[i] += alpha*ds[i];
    for (i = 0; i < 40; i++)
      work.z[i] += alpha*dz[i];
    for (i = 0; i < 39; i++)
      work.y[i] += alpha*dy[i];
    work.gap = eval_gap();
    work.eq_resid_squared = calc_eq_resid_squared();
    work.ineq_resid_squared = calc_ineq_resid_squared();
#ifndef ZERO_LIBRARY_MODE
    if (settings.verbose) {
      work.optval = eval_objv();
      printf("%3d   %10.3e  %9.2e  %9.2e  %9.2e  % 6.4f\n",
          iter+1, work.optval, work.gap, sqrt(work.eq_resid_squared),
          sqrt(work.ineq_resid_squared), alpha);
    }
#endif
    /* Test termination conditions. Requires optimality, and satisfied */
    /* constraints. */
    if (   (work.gap < settings.eps)
        && (work.eq_resid_squared <= settings.resid_tol*settings.resid_tol)
        && (work.ineq_resid_squared <= settings.resid_tol*settings.resid_tol)
       ) {
      work.converged = 1;
      work.optval = eval_objv();
      return iter+1;
    }
  }
  return iter;
}

void ldl_solve(double *target, double *var) {
  int i;
  /* Find var = (L*diag(work.d)*L') \ target, then unpermute. */
  /* Answer goes into var. */
  /* Forward substitution. */
  /* Include permutation as we retrieve from target. Use v so we can unpermute */
  /* later. */
  work.v[0] = target[59];
  work.v[1] = target[60];
  work.v[2] = target[61];
  work.v[3] = target[62];
  work.v[4] = target[63];
  work.v[5] = target[64];
  work.v[6] = target[65];
  work.v[7] = target[66];
  work.v[8] = target[67];
  work.v[9] = target[68];
  work.v[10] = target[69];
  work.v[11] = target[70];
  work.v[12] = target[71];
  work.v[13] = target[72];
  work.v[14] = target[73];
  work.v[15] = target[74];
  work.v[16] = target[75];
  work.v[17] = target[76];
  work.v[18] = target[77];
  work.v[19] = target[78];
  work.v[20] = target[79];
  work.v[21] = target[80];
  work.v[22] = target[81];
  work.v[23] = target[82];
  work.v[24] = target[83];
  work.v[25] = target[84];
  work.v[26] = target[85];
  work.v[27] = target[86];
  work.v[28] = target[87];
  work.v[29] = target[88];
  work.v[30] = target[89];
  work.v[31] = target[90];
  work.v[32] = target[91];
  work.v[33] = target[92];
  work.v[34] = target[93];
  work.v[35] = target[94];
  work.v[36] = target[95];
  work.v[37] = target[96];
  work.v[38] = target[97];
  work.v[39] = target[98];
  work.v[40] = target[99]-work.L[0]*work.v[0];
  work.v[41] = target[119]-work.L[1]*work.v[20];
  work.v[42] = target[0];
  work.v[43] = target[1];
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
  work.v[128] = target[41]-work.L[86]*work.v[127];
  work.v[129] = target[22]-work.L[87]*work.v[66]-work.L[88]*work.v[67]-work.L[89]*work.v[103]-work.L[90]*work.v[104]-work.L[91]*work.v[126]-work.L[92]*work.v[127]-work.L[93]*work.v[128];
  work.v[130] = target[161]-work.L[94]*work.v[128]-work.L[95]*work.v[129];
  work.v[131] = target[42]-work.L[96]*work.v[130];
  work.v[132] = target[23]-work.L[97]*work.v[68]-work.L[98]*work.v[69]-work.L[99]*work.v[104]-work.L[100]*work.v[105]-work.L[101]*work.v[129]-work.L[102]*work.v[130]-work.L[103]*work.v[131];
  work.v[133] = target[162]-work.L[104]*work.v[131]-work.L[105]*work.v[132];
  work.v[134] = target[43]-work.L[106]*work.v[133];
  work.v[135] = target[24]-work.L[107]*work.v[70]-work.L[108]*work.v[71]-work.L[109]*work.v[105]-work.L[110]*work.v[106]-work.L[111]*work.v[132]-work.L[112]*work.v[133]-work.L[113]*work.v[134];
  work.v[136] = target[163]-work.L[114]*work.v[134]-work.L[115]*work.v[135];
  work.v[137] = target[44]-work.L[116]*work.v[136];
  work.v[138] = target[25]-work.L[117]*work.v[72]-work.L[118]*work.v[73]-work.L[119]*work.v[106]-work.L[120]*work.v[107]-work.L[121]*work.v[135]-work.L[122]*work.v[136]-work.L[123]*work.v[137];
  work.v[139] = target[164]-work.L[124]*work.v[137]-work.L[125]*work.v[138];
  work.v[140] = target[45]-work.L[126]*work.v[139];
  work.v[141] = target[26]-work.L[127]*work.v[74]-work.L[128]*work.v[75]-work.L[129]*work.v[107]-work.L[130]*work.v[108]-work.L[131]*work.v[138]-work.L[132]*work.v[139]-work.L[133]*work.v[140];
  work.v[142] = target[165]-work.L[134]*work.v[140]-work.L[135]*work.v[141];
  work.v[143] = target[46]-work.L[136]*work.v[142];
  work.v[144] = target[27]-work.L[137]*work.v[76]-work.L[138]*work.v[77]-work.L[139]*work.v[108]-work.L[140]*work.v[109]-work.L[141]*work.v[141]-work.L[142]*work.v[142]-work.L[143]*work.v[143];
  work.v[145] = target[166]-work.L[144]*work.v[143]-work.L[145]*work.v[144];
  work.v[146] = target[47]-work.L[146]*work.v[145];
  work.v[147] = target[28]-work.L[147]*work.v[78]-work.L[148]*work.v[79]-work.L[149]*work.v[109]-work.L[150]*work.v[110]-work.L[151]*work.v[144]-work.L[152]*work.v[145]-work.L[153]*work.v[146];
  work.v[148] = target[167]-work.L[154]*work.v[146]-work.L[155]*work.v[147];
  work.v[149] = target[48]-work.L[156]*work.v[148];
  work.v[150] = target[29]-work.L[157]*work.v[80]-work.L[158]*work.v[81]-work.L[159]*work.v[110]-work.L[160]*work.v[111]-work.L[161]*work.v[147]-work.L[162]*work.v[148]-work.L[163]*work.v[149];
  work.v[151] = target[168]-work.L[164]*work.v[149]-work.L[165]*work.v[150];
  work.v[152] = target[49]-work.L[166]*work.v[151];
  work.v[153] = target[30]-work.L[167]*work.v[82]-work.L[168]*work.v[83]-work.L[169]*work.v[111]-work.L[170]*work.v[112]-work.L[171]*work.v[150]-work.L[172]*work.v[151]-work.L[173]*work.v[152];
  work.v[154] = target[169]-work.L[174]*work.v[152]-work.L[175]*work.v[153];
  work.v[155] = target[50]-work.L[176]*work.v[154];
  work.v[156] = target[31]-work.L[177]*work.v[84]-work.L[178]*work.v[85]-work.L[179]*work.v[112]-work.L[180]*work.v[113]-work.L[181]*work.v[153]-work.L[182]*work.v[154]-work.L[183]*work.v[155];
  work.v[157] = target[170]-work.L[184]*work.v[155]-work.L[185]*work.v[156];
  work.v[158] = target[51]-work.L[186]*work.v[157];
  work.v[159] = target[32]-work.L[187]*work.v[86]-work.L[188]*work.v[87]-work.L[189]*work.v[113]-work.L[190]*work.v[114]-work.L[191]*work.v[156]-work.L[192]*work.v[157]-work.L[193]*work.v[158];
  work.v[160] = target[171]-work.L[194]*work.v[158]-work.L[195]*work.v[159];
  work.v[161] = target[52]-work.L[196]*work.v[160];
  work.v[162] = target[33]-work.L[197]*work.v[88]-work.L[198]*work.v[89]-work.L[199]*work.v[114]-work.L[200]*work.v[115]-work.L[201]*work.v[159]-work.L[202]*work.v[160]-work.L[203]*work.v[161];
  work.v[163] = target[172]-work.L[204]*work.v[161]-work.L[205]*work.v[162];
  work.v[164] = target[53]-work.L[206]*work.v[163];
  work.v[165] = target[34]-work.L[207]*work.v[90]-work.L[208]*work.v[91]-work.L[209]*work.v[115]-work.L[210]*work.v[116]-work.L[211]*work.v[162]-work.L[212]*work.v[163]-work.L[213]*work.v[164];
  work.v[166] = target[173]-work.L[214]*work.v[164]-work.L[215]*work.v[165];
  work.v[167] = target[54]-work.L[216]*work.v[166];
  work.v[168] = target[35]-work.L[217]*work.v[92]-work.L[218]*work.v[93]-work.L[219]*work.v[116]-work.L[220]*work.v[117]-work.L[221]*work.v[165]-work.L[222]*work.v[166]-work.L[223]*work.v[167];
  work.v[169] = target[174]-work.L[224]*work.v[167]-work.L[225]*work.v[168];
  work.v[170] = target[55]-work.L[226]*work.v[169];
  work.v[171] = target[36]-work.L[227]*work.v[94]-work.L[228]*work.v[95]-work.L[229]*work.v[117]-work.L[230]*work.v[118]-work.L[231]*work.v[168]-work.L[232]*work.v[169]-work.L[233]*work.v[170];
  work.v[172] = target[175]-work.L[234]*work.v[170]-work.L[235]*work.v[171];
  work.v[173] = target[56]-work.L[236]*work.v[172];
  work.v[174] = target[37]-work.L[237]*work.v[96]-work.L[238]*work.v[97]-work.L[239]*work.v[118]-work.L[240]*work.v[119]-work.L[241]*work.v[171]-work.L[242]*work.v[172]-work.L[243]*work.v[173];
  work.v[175] = target[57];
  work.v[176] = target[176]-work.L[244]*work.v[173]-work.L[245]*work.v[174]-work.L[246]*work.v[175];
  work.v[177] = target[177]-work.L[247]*work.v[61]-work.L[248]*work.v[100]-work.L[249]*work.v[119]-work.L[250]*work.v[174]-work.L[251]*work.v[175]-work.L[252]*work.v[176];
  /* Diagonal scaling. Assume correctness of work.d_inv. */
  for (i = 0; i < 178; i++)
    work.v[i] *= work.d_inv[i];
  /* Back substitution */
  work.v[176] -= work.L[252]*work.v[177];
  work.v[175] -= work.L[246]*work.v[176]+work.L[251]*work.v[177];
  work.v[174] -= work.L[245]*work.v[176]+work.L[250]*work.v[177];
  work.v[173] -= work.L[243]*work.v[174]+work.L[244]*work.v[176];
  work.v[172] -= work.L[236]*work.v[173]+work.L[242]*work.v[174];
  work.v[171] -= work.L[235]*work.v[172]+work.L[241]*work.v[174];
  work.v[170] -= work.L[233]*work.v[171]+work.L[234]*work.v[172];
  work.v[169] -= work.L[226]*work.v[170]+work.L[232]*work.v[171];
  work.v[168] -= work.L[225]*work.v[169]+work.L[231]*work.v[171];
  work.v[167] -= work.L[223]*work.v[168]+work.L[224]*work.v[169];
  work.v[166] -= work.L[216]*work.v[167]+work.L[222]*work.v[168];
  work.v[165] -= work.L[215]*work.v[166]+work.L[221]*work.v[168];
  work.v[164] -= work.L[213]*work.v[165]+work.L[214]*work.v[166];
  work.v[163] -= work.L[206]*work.v[164]+work.L[212]*work.v[165];
  work.v[162] -= work.L[205]*work.v[163]+work.L[211]*work.v[165];
  work.v[161] -= work.L[203]*work.v[162]+work.L[204]*work.v[163];
  work.v[160] -= work.L[196]*work.v[161]+work.L[202]*work.v[162];
  work.v[159] -= work.L[195]*work.v[160]+work.L[201]*work.v[162];
  work.v[158] -= work.L[193]*work.v[159]+work.L[194]*work.v[160];
  work.v[157] -= work.L[186]*work.v[158]+work.L[192]*work.v[159];
  work.v[156] -= work.L[185]*work.v[157]+work.L[191]*work.v[159];
  work.v[155] -= work.L[183]*work.v[156]+work.L[184]*work.v[157];
  work.v[154] -= work.L[176]*work.v[155]+work.L[182]*work.v[156];
  work.v[153] -= work.L[175]*work.v[154]+work.L[181]*work.v[156];
  work.v[152] -= work.L[173]*work.v[153]+work.L[174]*work.v[154];
  work.v[151] -= work.L[166]*work.v[152]+work.L[172]*work.v[153];
  work.v[150] -= work.L[165]*work.v[151]+work.L[171]*work.v[153];
  work.v[149] -= work.L[163]*work.v[150]+work.L[164]*work.v[151];
  work.v[148] -= work.L[156]*work.v[149]+work.L[162]*work.v[150];
  work.v[147] -= work.L[155]*work.v[148]+work.L[161]*work.v[150];
  work.v[146] -= work.L[153]*work.v[147]+work.L[154]*work.v[148];
  work.v[145] -= work.L[146]*work.v[146]+work.L[152]*work.v[147];
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
    work.d[174] = settings.kkt_reg;
  else
    work.d[174] += settings.kkt_reg;
  work.d_inv[174] = 1/work.d[174];
  work.L[245] = (work.KKT[312]-work.L[244]*work.v[173])*work.d_inv[174];
  work.L[250] = (-work.L[249]*work.v[119])*work.d_inv[174];
  work.v[175] = work.KKT[313];
  work.d[175] = work.v[175];
  if (work.d[175] < 0)
    work.d[175] = settings.kkt_reg;
  else
    work.d[175] += settings.kkt_reg;
  work.d_inv[175] = 1/work.d[175];
  work.L[246] = (work.KKT[314])*work.d_inv[175];
  work.L[251] = (work.KKT[315])*work.d_inv[175];
  work.v[173] = work.L[244]*work.d[173];
  work.v[174] = work.L[245]*work.d[174];
  work.v[175] = work.L[246]*work.d[175];
  work.v[176] = 0-work.L[244]*work.v[173]-work.L[245]*work.v[174]-work.L[246]*work.v[175];
  work.d[176] = work.v[176];
  if (work.d[176] > 0)
    work.d[176] = -settings.kkt_reg;
  else
    work.d[176] -= settings.kkt_reg;
  work.d_inv[176] = 1/work.d[176];
  work.L[252] = (-work.L[250]*work.v[174]-work.L[251]*work.v[175])*work.d_inv[176];
  work.v[61] = work.L[247]*work.d[61];
  work.v[100] = work.L[248]*work.d[100];
  work.v[119] = work.L[249]*work.d[119];
  work.v[174] = work.L[250]*work.d[174];
  work.v[175] = work.L[251]*work.d[175];
  work.v[176] = work.L[252]*work.d[176];
  work.v[177] = 0-work.L[247]*work.v[61]-work.L[248]*work.v[100]-work.L[249]*work.v[119]-work.L[250]*work.v[174]-work.L[251]*work.v[175]-work.L[252]*work.v[176];
  work.d[177] = work.v[177];
  if (work.d[177] > 0)
    work.d[177] = -settings.kkt_reg;
  else
    work.d[177] -= settings.kkt_reg;
  work.d_inv[177] = 1/work.d[177];
#ifndef ZERO_LIBRARY_MODE
  if (settings.debug) {
    printf("Squared Frobenius for factorization is %.8g.\n", check_factorization());
  }
#endif
}
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
