getc1995/Scaled-Robot-Cars/(notices)

Notices in the files:
code/ubuntu/RC2/um_acc/src/rs232.cpp:
This program is free software: you can redistribute it and/or modify
it under the terms of the GNU General Public License as published by
the Free Software Foundation, either version 3 of the License, or
(at your option) any later version.
